emp3thy/arcade-cabinet/docs/docs/README.md

# Docs

Numbered for reading order. `../CLAUDE.md` is the entry point.

| File | Read it when |
|---|---|
| `01-architecture.md` | You need the shape of the system |
| `02-bom.md` | Ordering, or checking what's already bought |
| `03-wiring-lap-pad.md` | Soldering a pad |
| `04-wiring-pi-console.md` | Wiring the Pi box |
| `05-retropie-config.md` | Anything software-side on the Pi |
| `06-enclosure-reference.md` | Doing CAD |
| `07-testing.md` | Bringing hardware up, or signing off |
| `08-open-issues.md` | **Before building the power chain** |
| `09-decision-log.md` | Before changing anything |
| `../comfort-study/` | Ergonomics research and the three comfort variants (2026-09-12) |
