emp3thy/arcade-cabinet/docs/comfort-study/research-2-fightsticks.md

# Research report 2 — fightstick community and manufacturer lap-comfort knowledge

## 1. Stick table
Dims W x D x H mm (H incl. lever where noted). "Palm" = front edge to first control; NO manufacturer or reviewer publishes this, so every row is n/f (not found).

| Stick | W x D x H | kg | Panel | Underside | Palm | Lap-friendly? | Source |
|---|---|---|---|---|---|---|---|
| Qanba Obsidian 2 | 486x260x116 | 3.35 (Qanba) / 3.65 (manual) | plastic, chamfered front edge | full-bottom anti-slip pad | n/f | Yes: "doesn't feel uncomfortable on your lap"; user "wide enough... does not slide" | https://qanbausa.com/obsidian-2/ , https://www.tomsguide.com/gaming/gaming-peripherals/qanba-q7-obsidian-2-review |
| Qanba Drone 2 | 356x221x116 | 1.25 | plastic | 4 rubber corner feet | n/f | Mixed: light, user "sits comfortably in the lap" | https://qanbausa.com/drone-2/ , https://thearcadestick.com/qanba-drone-2/ |
| Qanba Obsidian (Q3) | 460x260x120 | ~3.0 | plastic + aluminium sides | rubber pads | n/f | Yes; Reddit: lasts longer on lap than HRAP N | https://www.profightstick.com/qanba-obsidian-review/ |
| Hori Fighting Stick Alpha | 410x300x120 | 2.7 (Hori); one review says 3.3 | plastic | 2 silicone-rubber pads | n/f | Yes: "rests on your lap easily"; Reddit: depth "fills the space between gut and knees" | https://www.techradar.com/gaming/hori-fighting-stick-alpha-review |
| Hori RAP N Hayabusa | 436x276x63 (body only) | 3.1 | plastic | friction pads | n/f | Mixed: pads praised; Reddit "too bulky for long term play unless I use a table" | https://thearcadestick.com/hori-real-arcade-pro-v-hayabusa/ |
| Victrix Pro FS | 413x279x57 (body) | 3.4-3.5 | aluminium, 6.28 deg wrist slope | foam lap pad on back panel + 2 rubberised panels | n/f | Most praised: "never felt fatigued", wrists less tired than Daija/Alpha. Cons: front headset socket "annoying for lap play" | https://www.turtlebeach.com/products/victrix-pro-fs-arcade-fight-stick , https://gamespace.com/all-articles/tech/victrix-pro-fs-arcade-stick-review/ |
| Razer Panthera Evo | 381x259x64 | 2.1 | plastic, sloped front drop-off | anti-slip rubber strips | n/f | Yes: "rests comfortably on my lap"; one Reddit user: big box "heats my man parts" | https://www.psu.com/reviews/razer-panthera-evo-arcade-stick-review-ps4/ |
| Razer Kitsune | 296x210x19 | 0.8 | aluminium top | full rubber grip layer | n/f | Yes: "0 issues playing in the lap"; cramped for large hands | https://thearcadestick.com/razer-kitsune/ |
| Hit Box / Ultra | 407x179x27 | 1.7 | acrylic on steel | magnetic plate, no-slip foam | n/f | Mixed: "most comfortable to spread out" vs tall boxes cause wrist pain | https://www.hitboxarcade.com/products/hit-box-pc |
| Snack Box Micro / XL | 254x127x13 / 318x152x13 | 0.36-0.9 / 0.45-1.0 | acrylic, rounded edges | neoprene pad | n/f | Micro needs Footsie extender; XL "don't have to squeeze your legs together" | https://thearcadestick.com/snack-box-micro-xl/ |
| Mad Catz TE2+ | ~394x305x64 (unverified) | 2.3 vs >3.4 (unverified) | metal base | non-slip foam at leg contact points | n/f | Split 40-comment thread: "perfect weight" vs "felt like lead" | https://www.reddit.com/r/fightsticks/comments/141aoge/ |
| Nacon Daija | 380x260x70 | 3.5-3.7 | plastic + rubber wrist pad | full rubberised plate | n/f | Mixed: "some may find the sheer weight uncomfortable"; wrist rest "could be more supportive" | https://www.pushsquare.com/features/hardware-review-nacon-daija-arcade-stick-a-ps5-ps4-and-pc-fighting-game-dream |
| AllFightSticks 15.5" case | 394x254x58 | 2.5 | steel/aluminium | n/f | n/f | "may challenge your legs' endurance during lap play" | https://thearcadestick.com/allfightsticks/ |

## 2. Community findings
1. Lap is the default position. Poll: 235 lap vs 46 desk. https://www.reddit.com/r/fightsticks/comments/1679poa/ Consensus.
2. Sliding is the top complaint and friction, not weight, is the fix. SRK 2007: "I put foam rubber on the bottom so they don't slip"; Reddit: non-slip tape "can make a real significant difference"; every current stick ships a near-full-bottom pad. https://archive.supercombo.gg/t/what-do-you-use-to-play-your-arcade-stick-on/24045 Consensus.
3. Weight is polarising; ~2-2.5 kg is the tolerated middle. "Usually the heavier the better but I guess there's a limit"; one user ranks session length HRAP4 (light) > Obsidian > HRAP N (bulky). Common.
4. Case height drives wrist pain more than weight. "Full size arcade button boxes are way too 'tall' to sit on my lap and not develop pain"; thin leverless (<38 mm) users report straight wrists; a thread hunts sub-1.5 in enclosures. https://www.reddit.com/r/fightsticks/comments/1fz6w3f/ Common (leverless).
5. Lap slope (knees below hips) tips the stick away; fixes: footrest, towel/blanket to level, sit forward with feet planted. 6 of 6 respondents agree. https://steamcommunity.com/app/310950/discussions/0/1795152172917478329 Common.
6. Front-edge geometry matters over hours: sloped/chamfered fronts (Victrix 6.28 deg, Panthera drop-off, Obsidian 2 chamfer) praised; sharp "angular drop offs... dig in after a while". Common (reviewers).
7. Width should match relaxed thigh spread. Builder measures leg spread seated before picking length; wide cases let you play "without having to squeeze your legs together". https://www.reddit.com/r/fightsticks/comments/161y6vu/ Common.
8. Depth should fill gut-to-knee so it cannot rock. Hori Alpha's 300 mm depth "won't be moving around"; a builder's 380x280x70 case was "horrible", replaced by 380x230x50. https://archive.supercombo.gg/t/arcade-stick-dimensions/164024 Minority.
9. Builder go-to size: 400x200 mm, 50-70 mm tall (5 builds). Single post.
10. Heat and sweat: legs and pad "get soaked" in long sessions; old metal bottoms rust at thigh contact; metal cases are cold in winter. Minority.
11. Palm resting is contested; agreed points: rest palms not wrists, keep wrist straight. A rest higher than the buttons is claimed better than lower. Contested.
12. Lap desk or lap pad plus wrist rest is the most-recommended add-on for small boxes. Common.

## 3. What builders do about it
- Non-slip: adhesive foam pads sold in pairs, 76 x 152-203 mm; 1.6 mm self-adhesive sheet; 3M anti-slip tape 140x140 mm, two pieces at each end; natural rubber mat 366x239 mm (Mayflash); yoga mat glued under, leather-covered; rug gripper cut to shape.
- Weight: steel plate 0.5-0.9 kg, fishing weights + hot glue, spare metal base plates. Shipped range: lever sticks 2.1-3.6 kg, leverless 0.8-1.7 kg.
- Wedge/slope: 6.28 deg (Victrix), ~6 deg front drop (Panthera), 11 deg wrist slant (Mixbox), lap table tilting to 30 deg.
- Height: leverless target <38 mm total; lever cases 50-70 mm body.
- Footprint: 380-410 x 230-260 mm lever; 400 x 200 leverless.
- Edges: chamfer or slope the front; round all edges (Snack Box).
- Palm space: Footsie extender, Haute42 extender shells, lap desk with cushion.
- Straps: none exist for lap; only shoulder straps for transport.
- Thigh cut-outs: none found in any product or build.

## 4. Gaps
- Palm-rest depth is unpublished everywhere.
- No controlled weight-vs-fatigue data; all anecdotal.
- Conflicting weights: TE2+, Snack Box Micro, Hori Alpha.
- forums.shoryuken.com unusable; only the supercombo archive.
- r/fightsticks sampled 12 threads, not exhaustively.
