emp3thy/arcade-cabinet/docs/comfort-study/research-3-lapboards.md

# Research report 3 — lap desks, lapboards, anthropometrics

## 1. Devices (W x D x H mm, weight, underside, tilt, sofa/lap verdict)

| Device | W x D x H mm | kg | Underside | Tilt | Sofa/lap verdict | Source |
|---|---|---|---|---|---|---|
| LapGear Designer | 439 x 338 x 71 | 0.91 | single microbead bean bag | 0 | Praised: "conforms to your lap for a strong and stable work platform" | https://www.techgearlab.com/topics/home/best-lap-desk , https://lapdesk.com/products/designer-lap-desk |
| Honey-Can-Do TBL-06320 | 593 x 400 x 64 | 1.44 | flat foam cushion | 0 | No stability reviews found | https://www.amazon.com/Honey-Can-Do-TBL-06320-Portable-Laptop-Handle/dp/B013TSVMJM |
| Huanuo dual-cushion (16 in model) | 550 x 370 x ~64 | 2.04 | two foam bolsters (two-rail) | not stated | Criticised: mouse pad puts laptop left so "weight rests more on your left leg"; devices "tilt forward" on lap | https://appleinsider.com/articles/23/06/03/huanuo-lap-desk-review-comfort-and-convenience-for-macbook-users |
| North Coast Posture-Rite | 394 x 337 tray, base 57 to 95 | 0.57 | styrofoam-bead bag, wedge | 0 to 20 deg | Vendor claims stable in bed/couch/wheelchair; unverified | https://www.rehabmart.com/product/posture-rite-lap-desk-6371.html |
| Logitech K400 Plus | 354 x 139 x 24 | 0.39 | flat rigid, feet | ~0 (unverified) | Praised: "less mass on your thighs" | https://www.gomechanicalkeyboard.com/comparisons/logitech-k400-vs-k400-plus-review/ |
| Corsair K63 Lapboard | 671 x 277 x 53 | 1.85 | flat memory foam, full width, 13 mm (PCPer) or ~25 mm (Inverse) | 0 | Praised comfortable; criticised heavy/hot, no centring bump, mouse slides because lap "rarely completely level" | https://pcper.com/2018/05/corsair-k63-wireless-mechanical-gaming-keyboard-and-lapboard-combo-review/ , https://www.pcworld.com/article/402216/corsair-k63-gaming-lapboard-review.html |
| Corsair Lapdog | 735 x 261 x 94 | 2.63 | memory foam with slight central bump | 0 | Criticised: "sit with legs apart in order to prevent any seesaw motion"; front drop-off "feels sharp on your palm" | https://m.hexus.net/tech/reviews/peripherals/92927-corsair-lapdog/?page=2 , https://www.kitguru.net/peripherals/leo-waldock/corsair-lapdog-review/ |
| Roccat Sova | 646 x 280 x 37 | 2.35 to 2.6 | four thick foam pads at corners | 0 | Praised: "the weight and how it's distributed"; can be shifted so keyboard sits square on lap; hard mouse surface slides due to leg incline | https://www.makeuseof.com/tag/roccat-sova-review/ , https://bit-tech.net/reviews/tech/peripherals/roccat-sova-mk-review/1/ |
| Razer Turret (Xbox) | dims unverified | 1.86 with tray | flat rigid, high-friction rubber pad | 0, angled wrist rest | Praised stays put; "play angle is lower than on a desk", fatigue in long sessions | https://www.techradar.com/reviews/razer-turret-for-xbox-one , https://www.thexboxhub.com/razer-turret-for-xbox-one-review/ |
| Couchmaster Cycon 2 | board 820 x 330 x 30; cushions 600 x 165 x 200 each | 1.7 + 2 x 0.66 | board bridges two cushions beside hips, not on thighs | 0 | Praised stable; criticised no lip, mouse slides if wrist overbalances | https://www.gadgetexplained.com/2021/08/nerdytec-couchmaster-cycon-2-review-lap.html , https://gamingtrend.com/reviews/couchmaster-cycon-2-review-comfy-couch-gaming-gear/ |

## 2. Anthropometrics

Computed from the ANSUR II working database CSV (US Army 2012, male n=4082, female n=1986, mm; https://calmcode.io/static/data/ergonomics.csv, origin https://phc.amedd.army.mil/topics/workplacehealth/ergo/Pages/Anthropometric-Database.aspx). 5th / 50th / 95th:

| Dimension | Male | Female |
|---|---|---|
| Hip breadth sitting | 333 / 378 / 431 | 348 / 397 / 456 |
| Thigh clearance (seat to top of thigh) | 157 / 180 / 207 | 145 / 167 / 191 |
| Thigh circumference, upper | 532 / 624 / 723 | 527 / 613 / 711 |
| Lower thigh circumference (above knee) | 359 / 408 / 463 | 347 / 398 / 465 |
| Popliteal height | 390 / 430 / 471 | 350 / 387 / 428 |
| Buttock-popliteal length | 459 / 502 / 548 | 441 / 483 / 535 |

Cross-checks: FAA HFDS ch.14 (1988 Army data) thigh clearance M 149/168/190, F 140/158/180. Pheasant British adults thigh thickness M 130/155/180, F 120/150/180. Army sample is leaner than civilians; treat 95th values as low.

Derived (estimates, unverified): upper-thigh width per leg is about half of seated hip breadth, 167 to 228 mm across genders and percentiles; circumference/pi gives 168 to 230 mm, consistent. Width just above the knee is about 110 to 150 mm. Thigh gap at the crotch is ~0. No published data on the inter-thigh gap in relaxed sitting was found; 0 to 100 mm at mid-thigh is a plausible range. Thigh crest spacing (the two contact lines) is therefore ~170 to 230 mm with knees together, growing to ~250 to 350 mm with a 100 mm knee gap. A 280 mm wide device sits with both edges on or outside the crests only while crest spacing is under ~250 mm; beyond that its edges ride the inner slopes and it can rock.

## 3. Findings

1. Conforming bean/microbead bases get the best stability comments on soft seating because they fill the valley between the thighs and the sofa cushion curve (TechGearLab, Wirecutter on LapGear Designer). Confidence: medium, reviewer consensus, no measurements.
2. Flat rigid foam works only when the board is wide enough and heavy enough to load both thighs (K63 full-width memory foam "helps it to set level"). Without a centring feature it drifts: PCWorld missed the Lapdog's "slight bump ... which helped keep it centered between my legs". Medium.
3. Two-rail bolster bases are the most criticised: Huanuo dual cushion loads one leg, Mind Reader "not as stable ... narrow bolstered padding design" (TechGearLab). Rails that do not match the user's thigh spacing produce rocking. Medium.
4. Mass helps friction but hurts if off-centre: Lapdog 2.63 kg still seesaws; Sova praised because mass is centred and the user can slide the keyboard square over the thighs. Keep centre of mass low and between the thigh crests. Medium-high.
5. Front edge: a steep front drop-off is painful on the palms (Lapdog); a padded, angled front wrist rest is praised (Turret, Sova). The lap desk raises the work surface off the thighs: Asundi et al. measured head tilt down 4 deg, neck flexion down 2 deg, wrist extension down 9 deg versus bare lap (https://www.researchgate.net/publication/41002099). High for the study, medium for edge geometry.
6. Tilt: thighs slope down to the knee on a sofa, so items slide forward (Sova, K63, Huanuo). Bean-bag desks offer 0 to 20 deg (Posture-Rite); lapboards are 0 deg and rely on lips or friction. A few degrees of rearward tilt or a front lip compensates. Medium.
7. Bypassing the thighs: Couchmaster bridges 200 mm cushions beside the hips; older patents (US2763522, US2596094) use struts to the chair seat retained by the thighs. Both avoid thigh-slope instability entirely. Medium.
8. Heat: full-contact foam or bead bases trap heat (TechGearLab, K63 users); patent US12402720 (2025, single foam block lap desk) adds front-to-rear cooling channels and a U-shaped "hugging" recess. Low.

## 4. Gaps

- No measured tilt or rocking tests exist; all stability verdicts are subjective.
- No beanbag-chair-specific reviews found.
- No anthropometric data on knee or thigh gap in relaxed sitting.
- DINED (Dutch) needs a login; not used.
- Razer Turret Xbox dimensions unverified; K63 foam thickness conflicts between sources.
- Corsair official weight page has no spec; 1.85 kg is from reviews.
