emp3thy/arcade-cabinet/cad/art/chunli.png

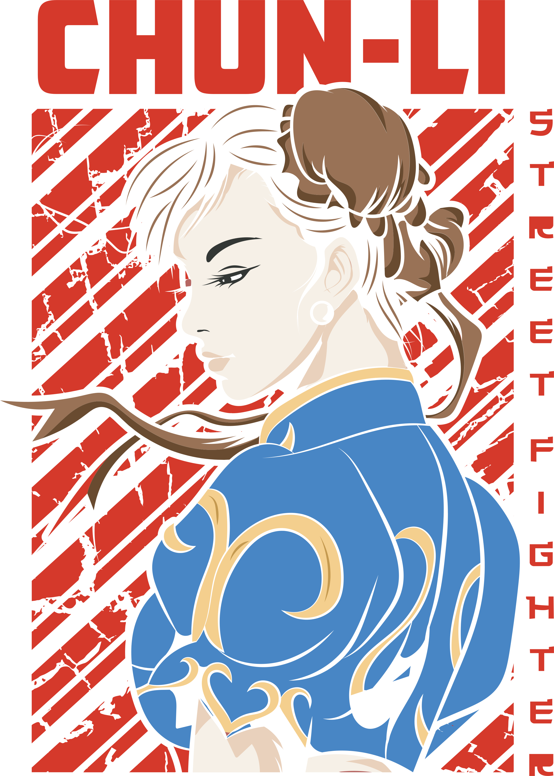
cad/art/chunli.png
