emp3thy/arcade-cabinet/cad/art/drum/chunli_sil.png

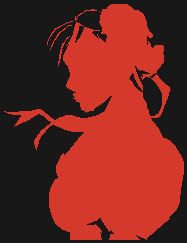
cad/art/drum/chunli_sil.png
