emp3thy/arcade-cabinet/cad/art/layers/all/_preview.png

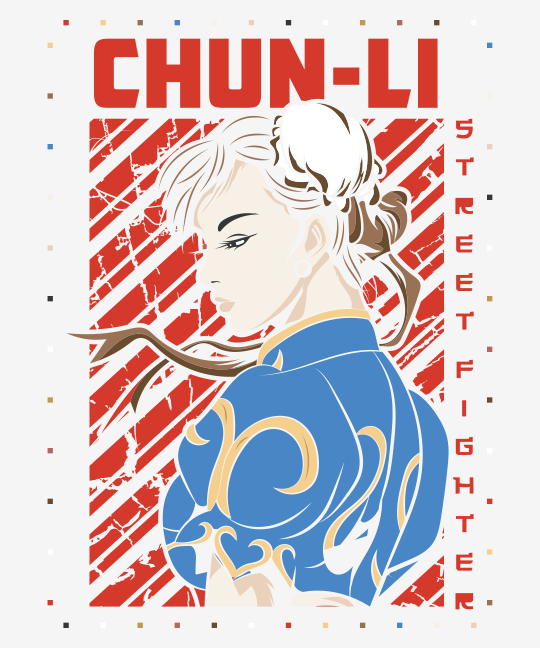
cad/art/layers/all/_preview.png
