emp3thy/arcade-cabinet/cad/art/layers/set5/_bun_white_brown.png

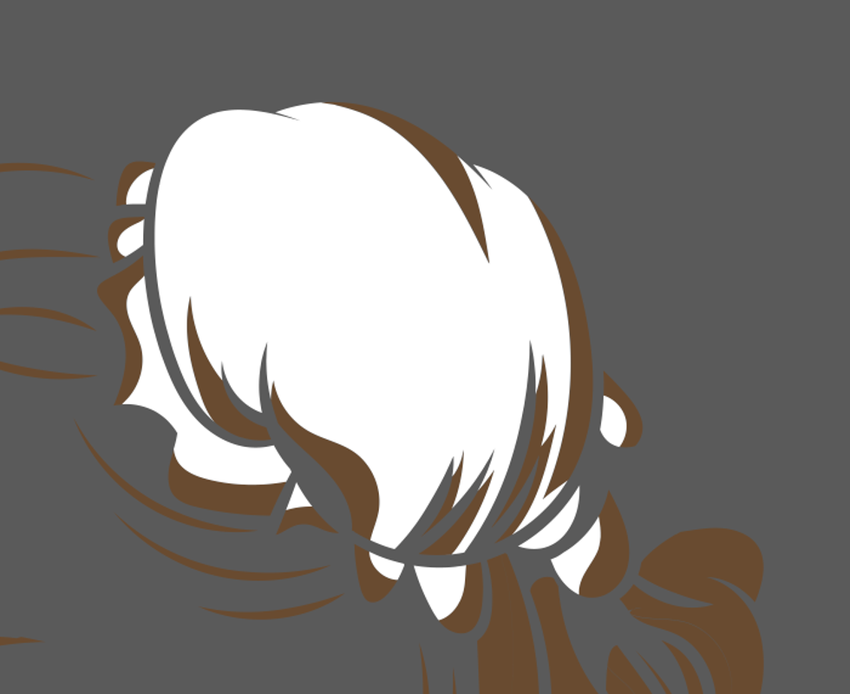
cad/art/layers/set5/_bun_white_brown.png
