emp3thy/arcade-cabinet/cad/renders/lap_disc_art_iso.png

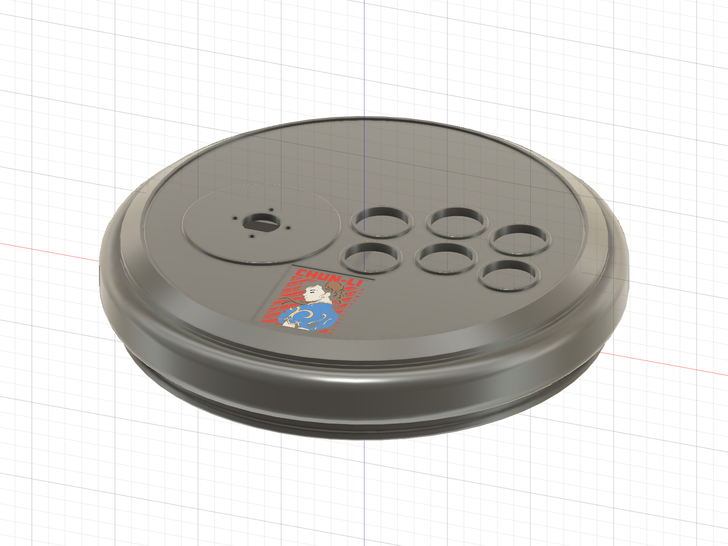
cad/renders/lap_disc_art_iso.png
