emp3thy/arcade-cabinet/cad/renders/lap_disc_art_pocket.png

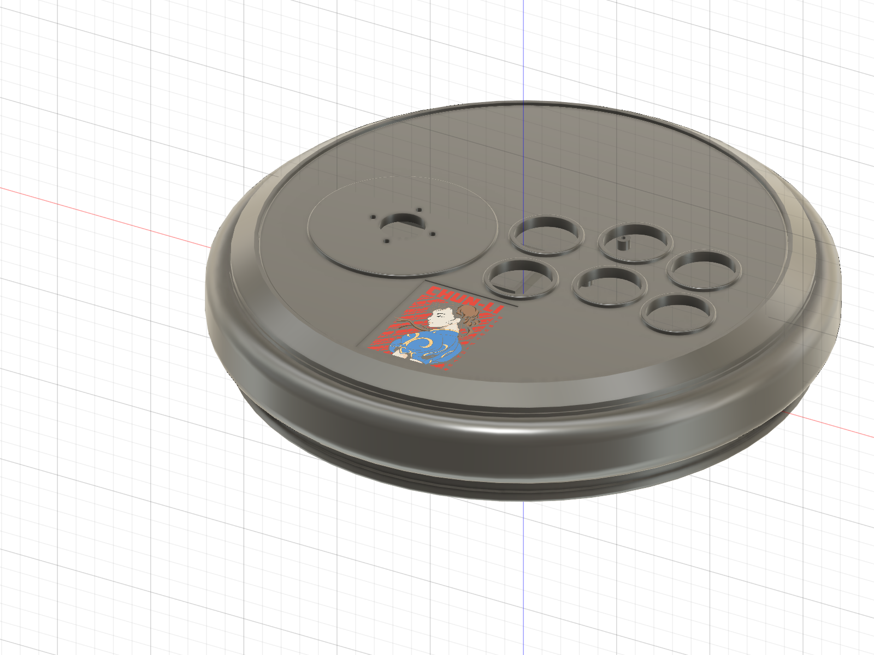
cad/renders/lap_disc_art_pocket.png
