emp3thy/arcade-cabinet/cad/renders/lap_disc_art_top.png

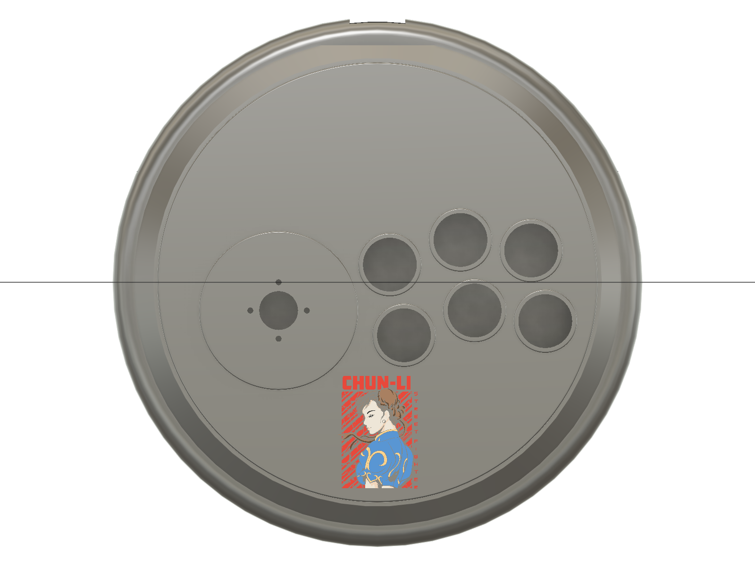
cad/renders/lap_disc_art_top.png
