emp3thy/arcade-cabinet/cad/renders/lap_disc_stageA_iso.png

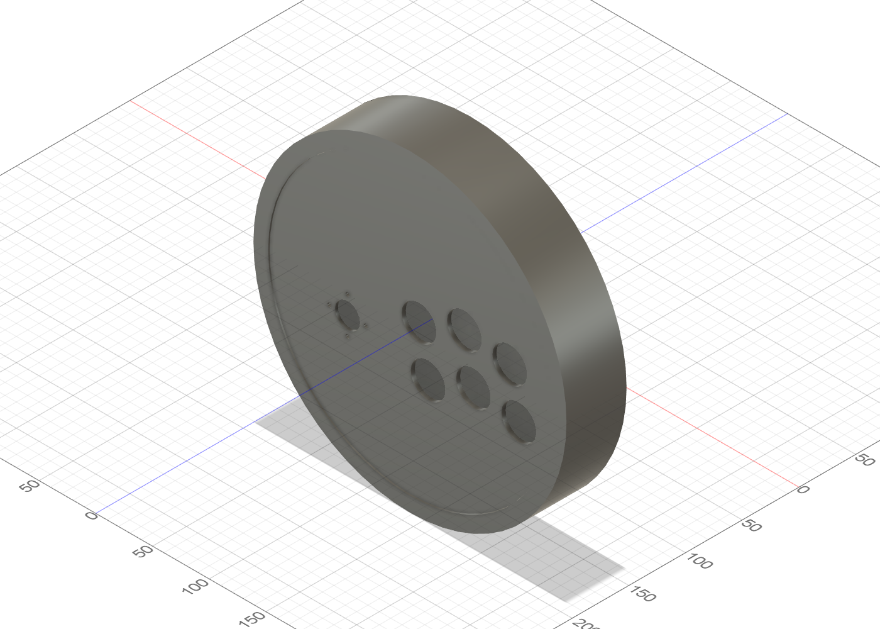
cad/renders/lap_disc_stageA_iso.png
