emp3thy/arcade-cabinet/cad/renders/lap_disc_stageB_iso.png

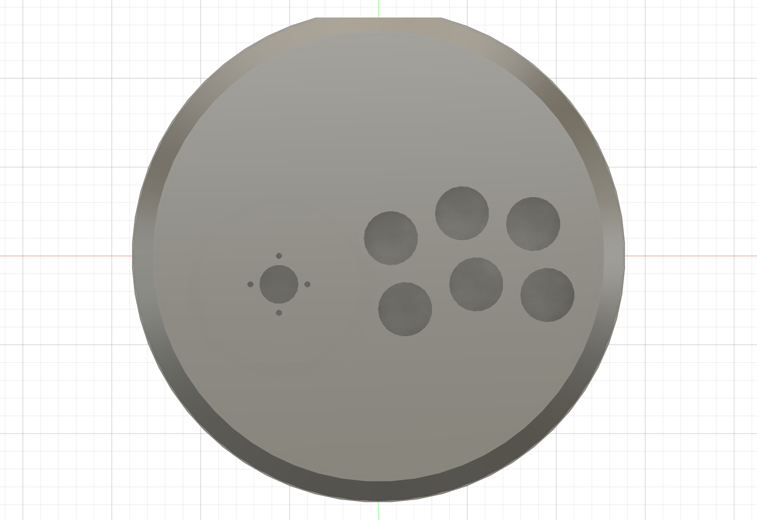
cad/renders/lap_disc_stageB_iso.png
