emp3thy/arcade-cabinet/cad/renders/lap_disc_stageC_iso.png

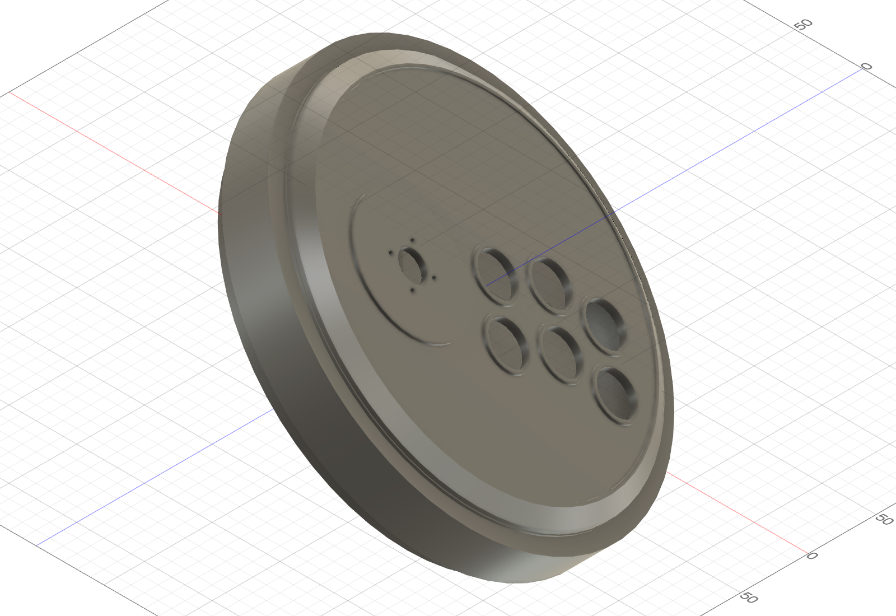
cad/renders/lap_disc_stageC_iso.png
