emp3thy/arcade-cabinet/cad/renders/lap_disc_stageC_underside.png

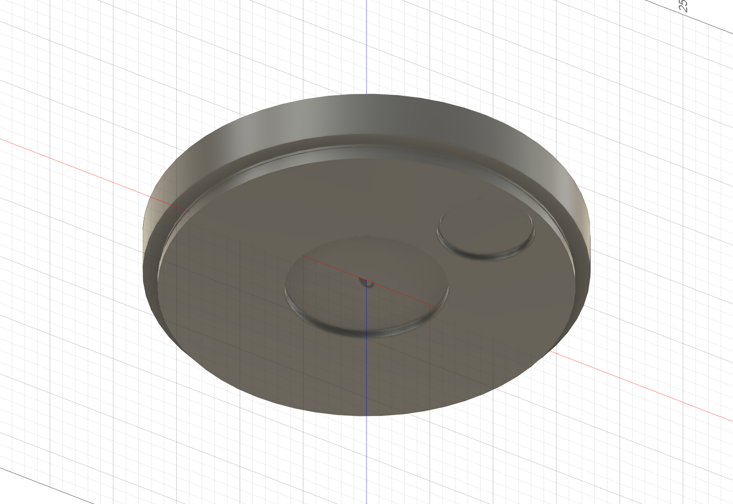
cad/renders/lap_disc_stageC_underside.png
