emp3thy/arcade-cabinet/cad/renders/lap_disc_stageD_edge.png

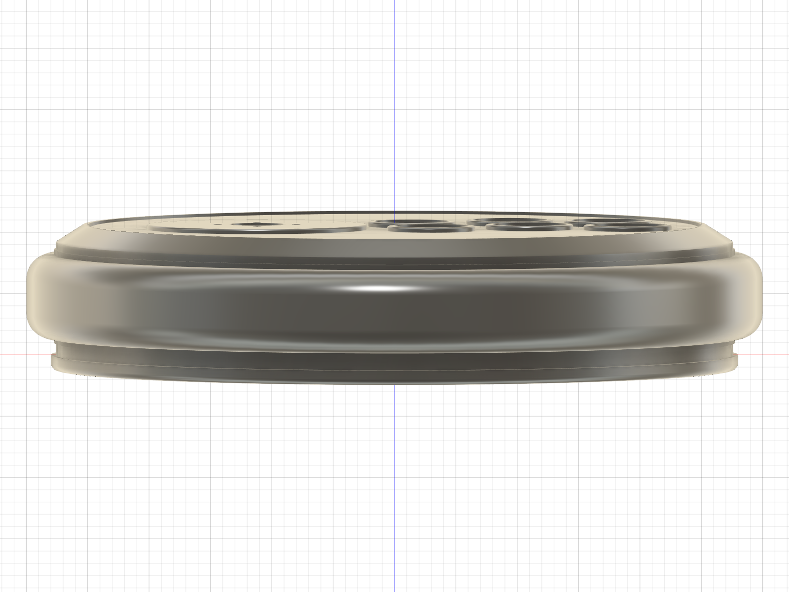
cad/renders/lap_disc_stageD_edge.png
