emp3thy/arcade-cabinet/cad/renders/lap_disc_stageD_iso.png

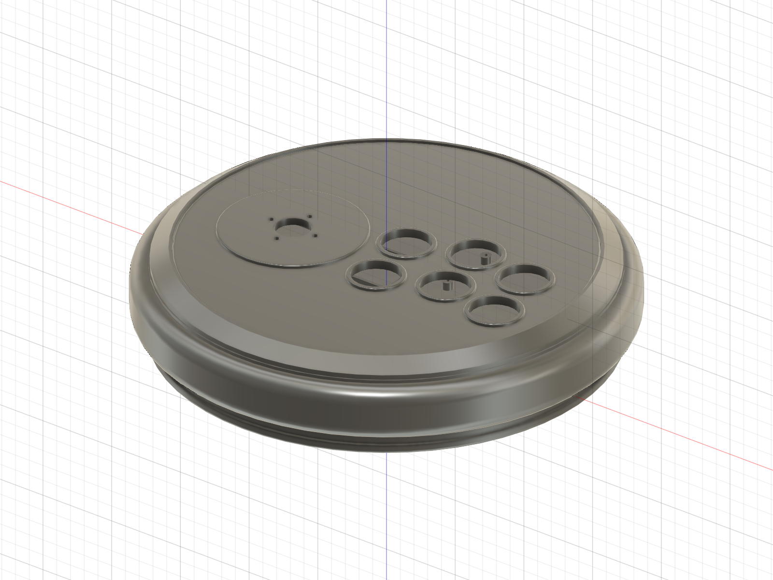
cad/renders/lap_disc_stageD_iso.png
