emp3thy/arcade-cabinet/cad/renders/lap_disc_stageD_underside.png

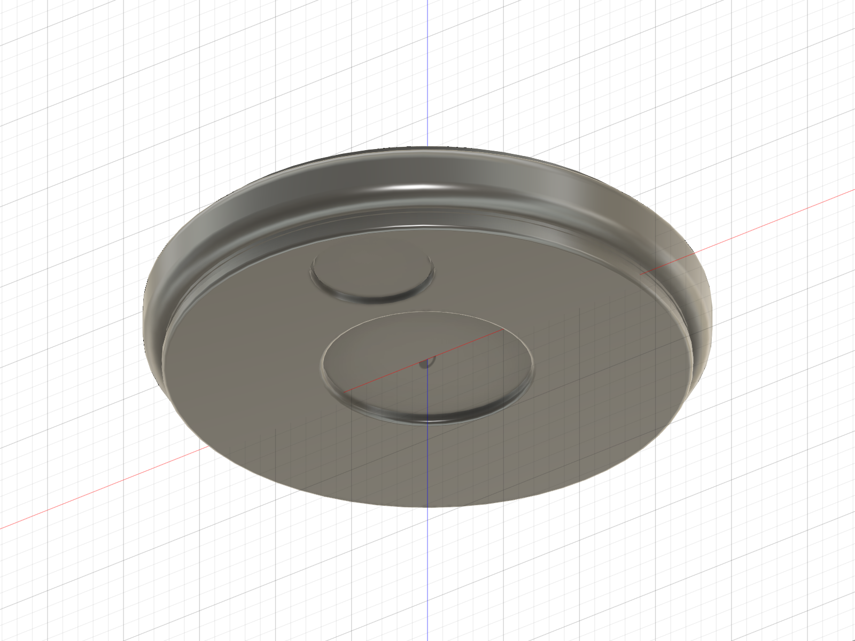
cad/renders/lap_disc_stageD_underside.png
