emp3thy/arcade-cabinet/cad/renders/lap_disc_stageE_rear_iso.png

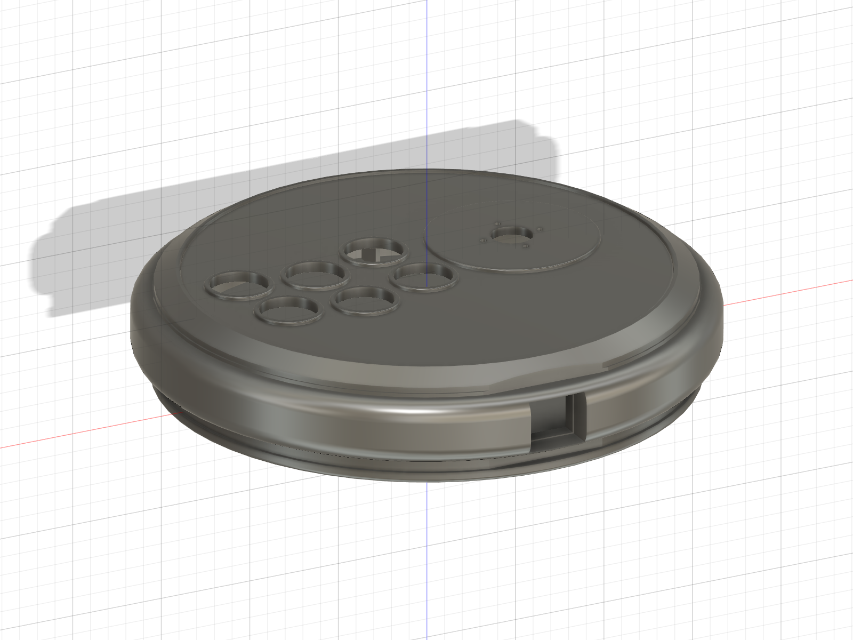
cad/renders/lap_disc_stageE_rear_iso.png
