emp3thy/arcade-cabinet/cad/renders/lap_disc_stageH_hoops.png

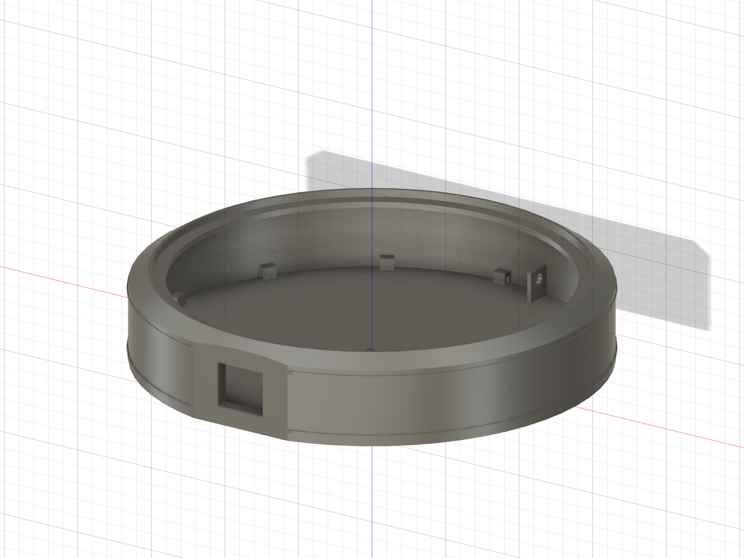
cad/renders/lap_disc_stageH_hoops.png
