emp3thy/arcade-cabinet/cad/renders/lap_disc_stageH_internals.png

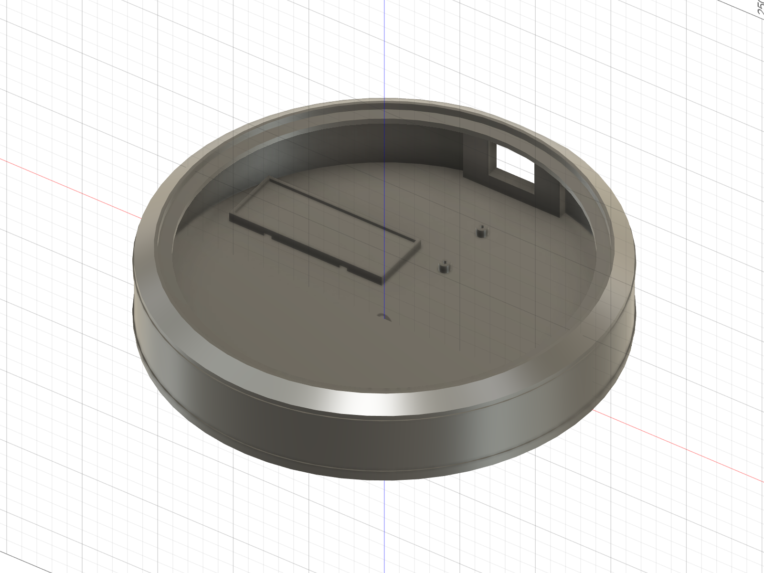
cad/renders/lap_disc_stageH_internals.png
