emp3thy/arcade-cabinet/cad/renders/lap_disc_stageH_lipo.png

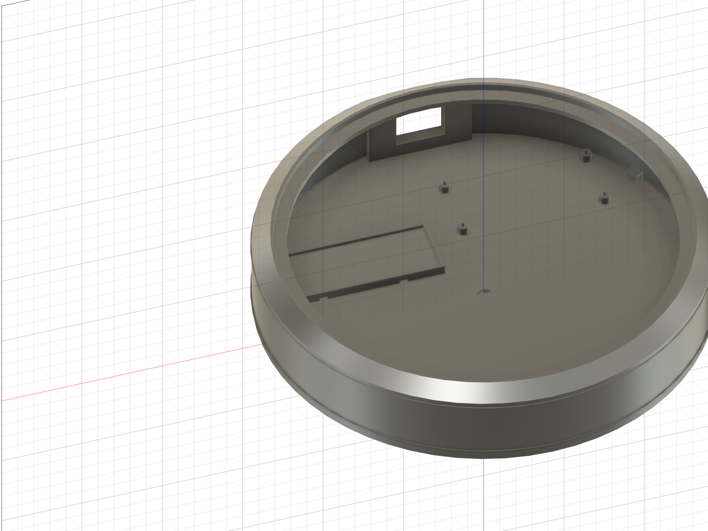
cad/renders/lap_disc_stageH_lipo.png
