emp3thy/arcade-cabinet/cad/renders/lap_disc_stageI_port_inside.png

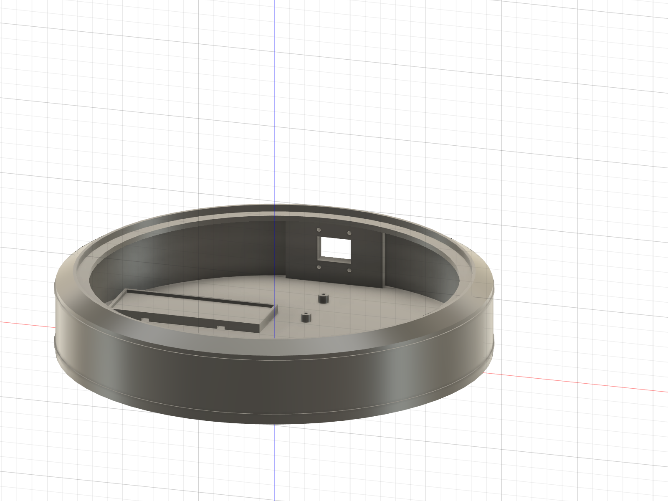
cad/renders/lap_disc_stageI_port_inside.png
