emp3thy/arcade-cabinet/cad/renders/lap_disc_stageI_port_outside.png

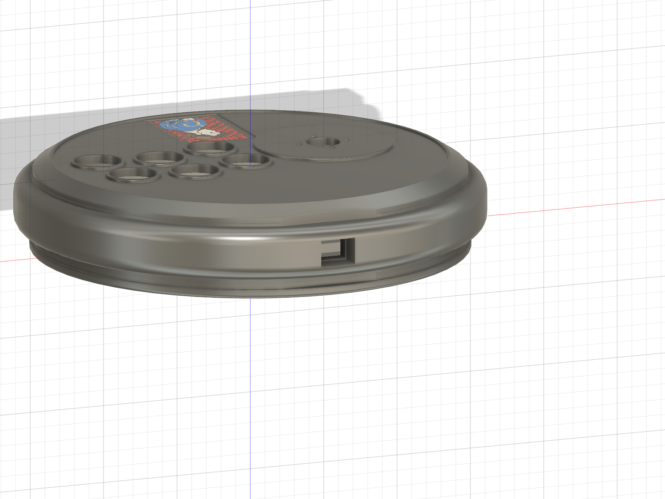
cad/renders/lap_disc_stageI_port_outside.png
