emp3thy/arcade-cabinet/cad/renders/lap_disc_stageJ_plate_under.png

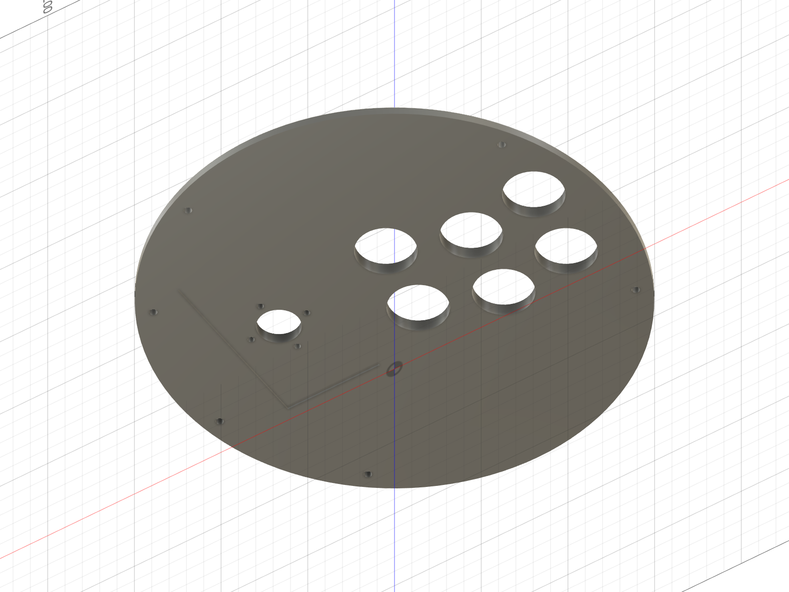
cad/renders/lap_disc_stageJ_plate_under.png
