emp3thy/arcade-cabinet/cad/renders/lap_disc_stageJ_ring_inside.png

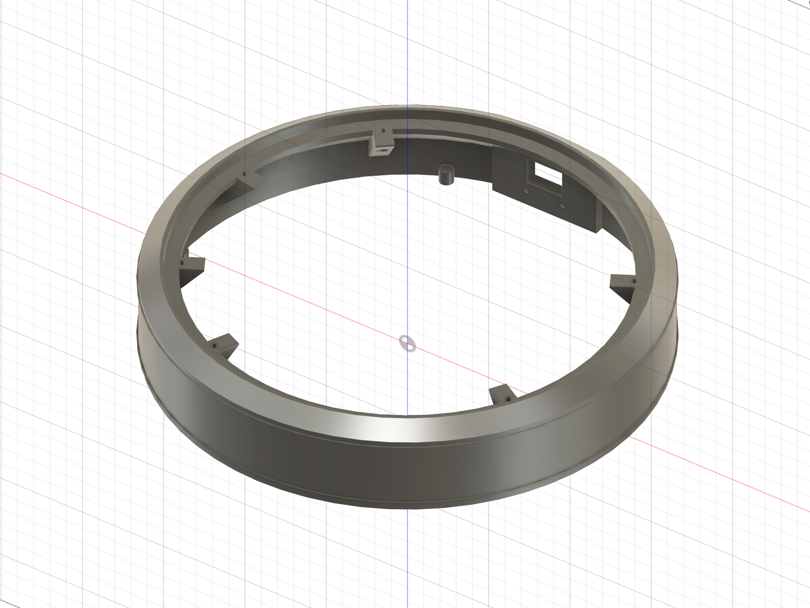
cad/renders/lap_disc_stageJ_ring_inside.png
