emp3thy/arcade-cabinet/cad/renders/lap_disc_stageJ_sled.png

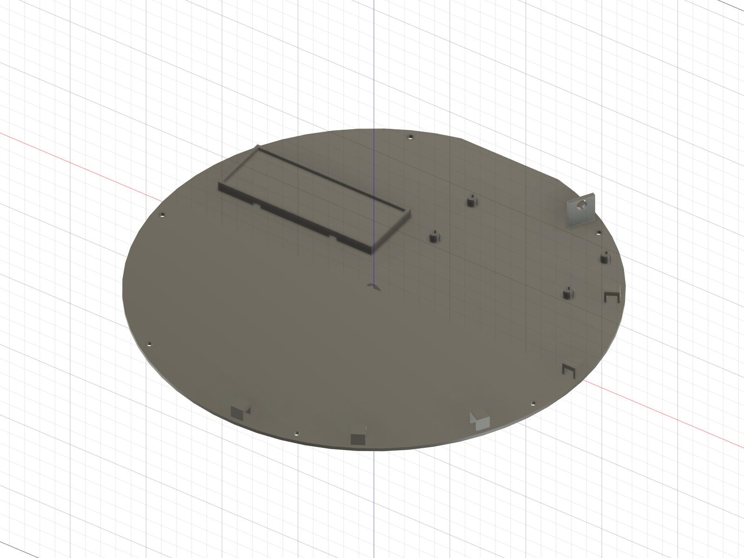
cad/renders/lap_disc_stageJ_sled.png
