emp3thy/arcade-cabinet/cad/renders/lap_disc_stageJ_tpu_below.png

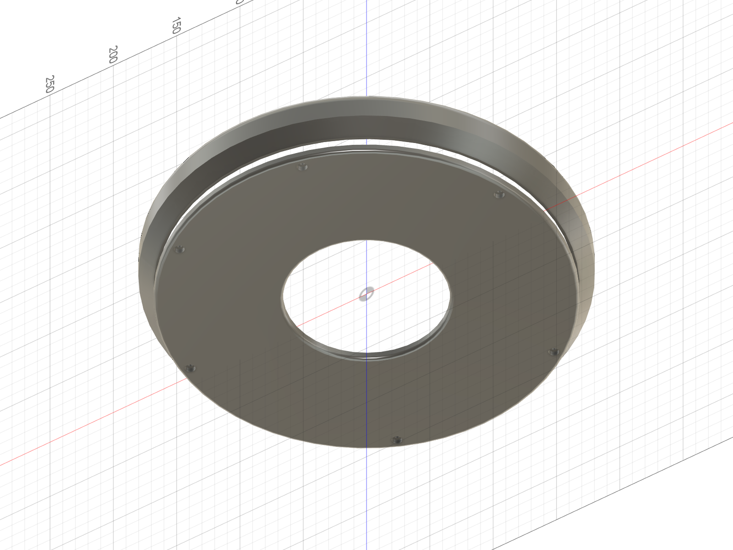
cad/renders/lap_disc_stageJ_tpu_below.png
