emp3thy/arcade-cabinet/cad/renders/lap_disc_stageK_ridges.png

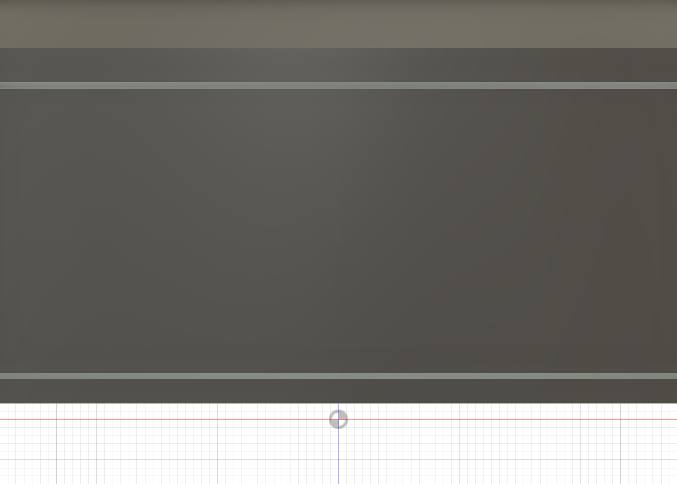
cad/renders/lap_disc_stageK_ridges.png
