emp3thy/arcade-cabinet/cad/renders/lap_disc_stageK_ring_below.png

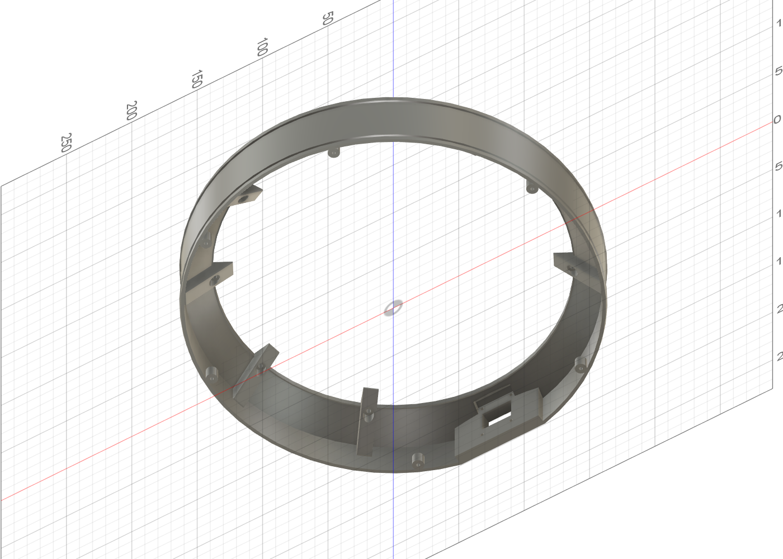
cad/renders/lap_disc_stageK_ring_below.png
