emp3thy/arcade-cabinet/cad/renders/lap_disc_stageK_sled_bolts.png

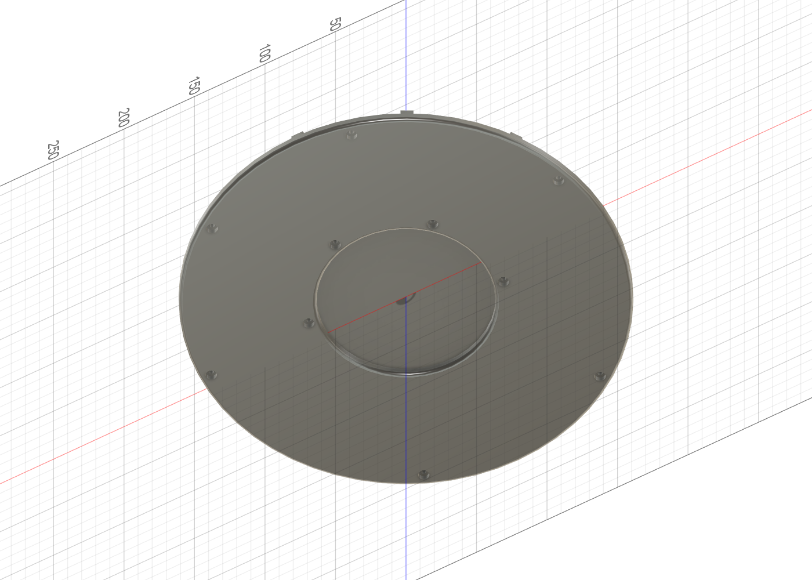
cad/renders/lap_disc_stageK_sled_bolts.png
