emp3thy/arcade-cabinet/cad/renders/lap_disc_stageL_boss_face2.png

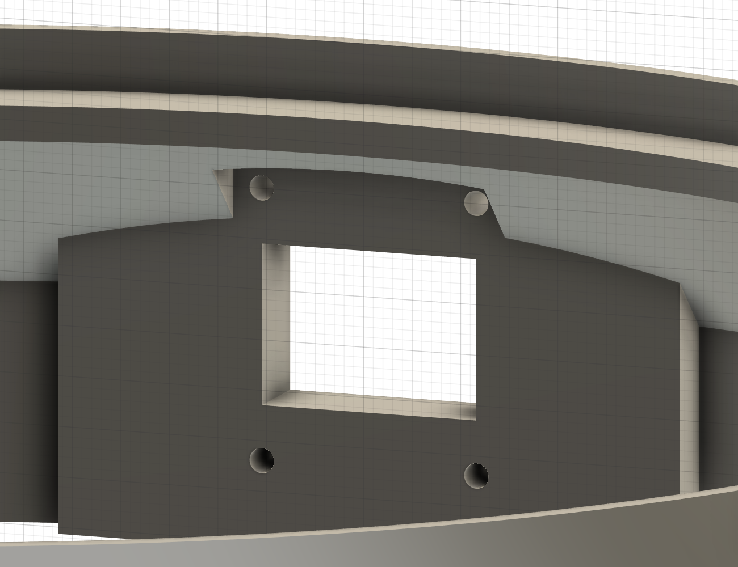
cad/renders/lap_disc_stageL_boss_face2.png
