emp3thy/arcade-cabinet/cad/renders/lap_disc_stageL_port_boss.png

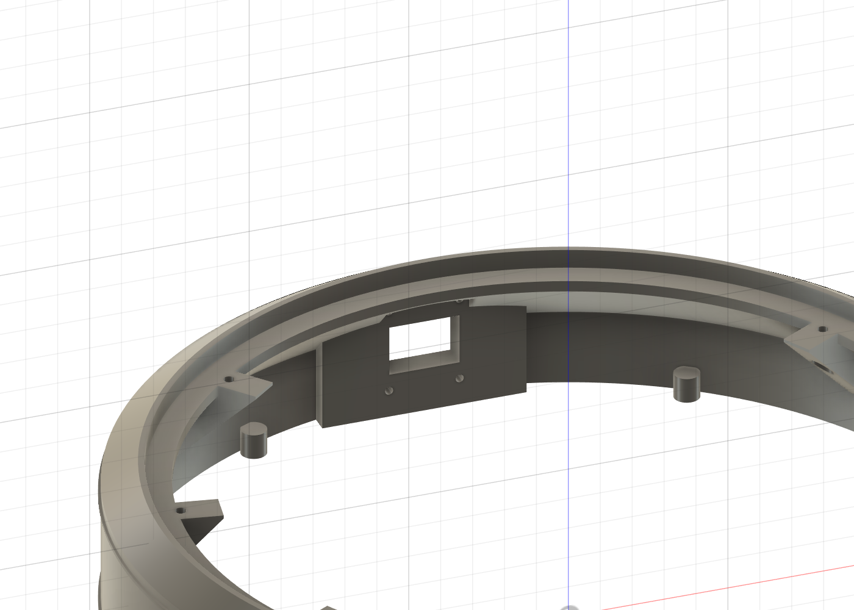
cad/renders/lap_disc_stageL_port_boss.png
