emp3thy/arcade-cabinet/cad/renders/lap_disc_stageL_ring_inside.png

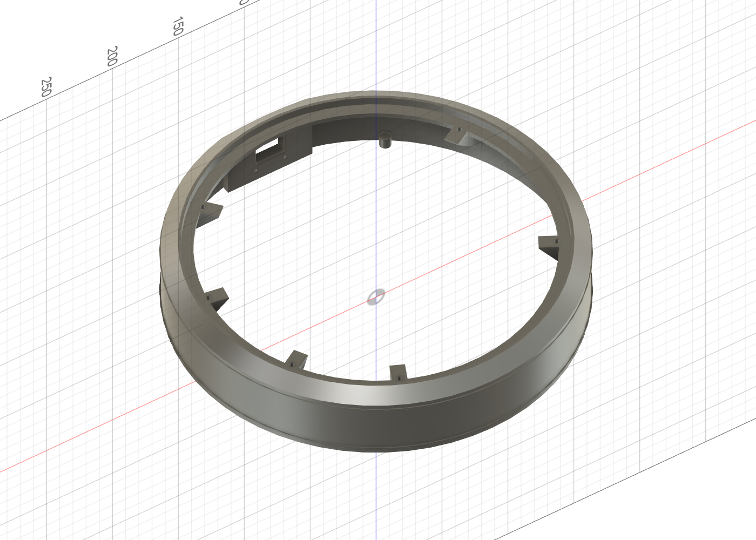
cad/renders/lap_disc_stageL_ring_inside.png
