emp3thy/arcade-cabinet/cad/renders/lap_disc_stageL_ring_port.png

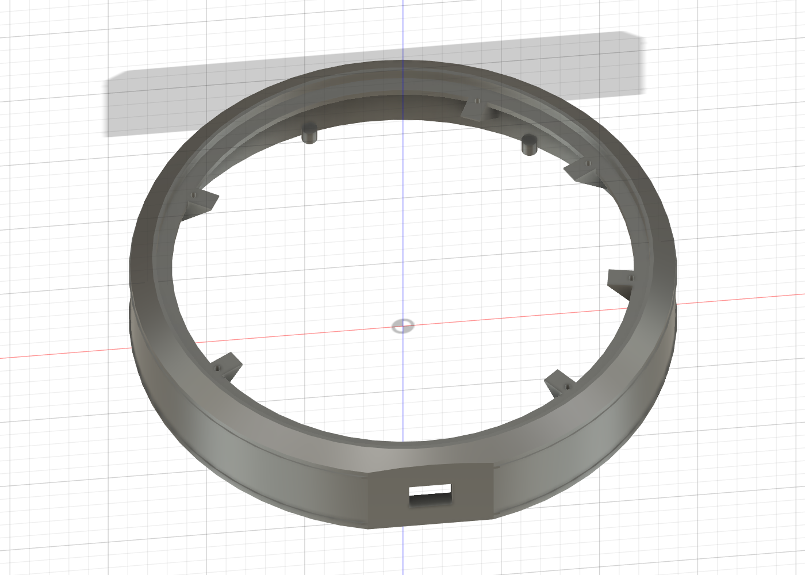
cad/renders/lap_disc_stageL_ring_port.png
