emp3thy/arcade-cabinet/cad/renders/lap_disc_stageO_bracket.png

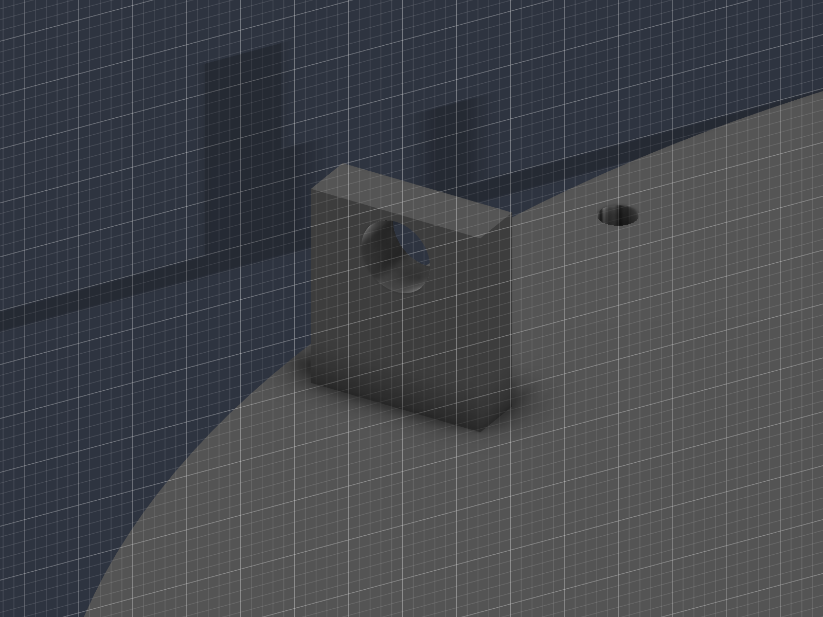
cad/renders/lap_disc_stageO_bracket.png
