emp3thy/arcade-cabinet/cad/renders/lap_disc_stageO_port_outside.png

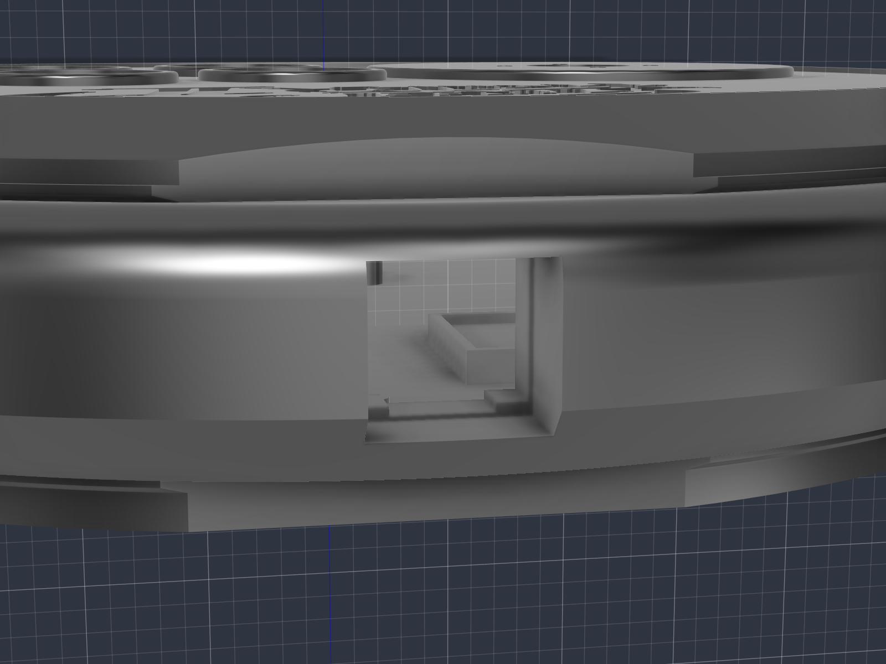
cad/renders/lap_disc_stageO_port_outside.png
