emp3thy/arcade-cabinet/cad/renders/lap_disc_stageO_sled_antenna.png

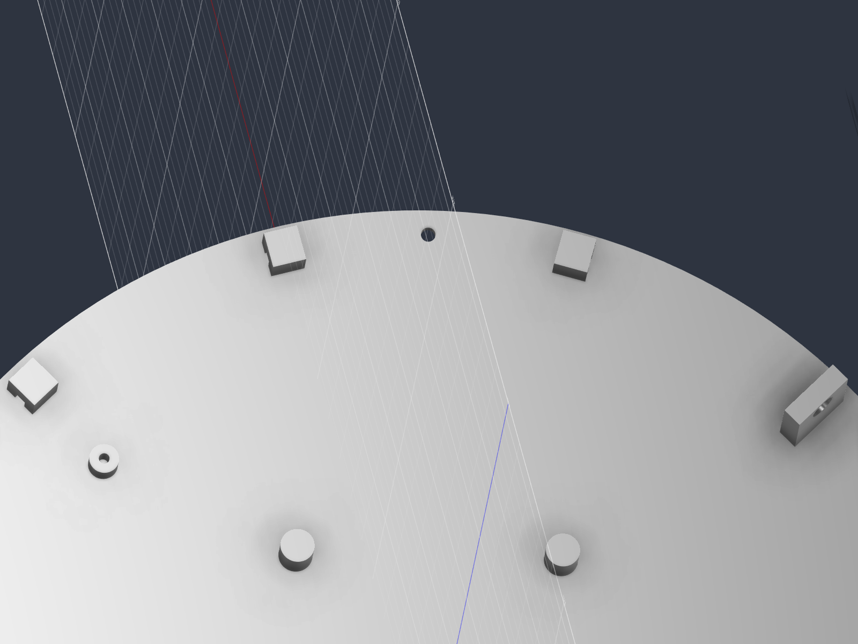
cad/renders/lap_disc_stageO_sled_antenna.png
