emp3thy/arcade-cabinet/cad/renders/pi_drum_stageA_iso.png

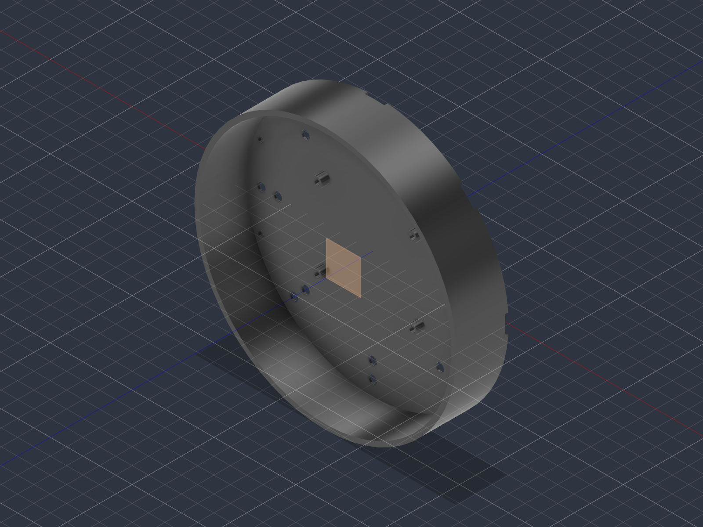
cad/renders/pi_drum_stageA_iso.png
