emp3thy/arcade-cabinet/cad/renders/pi_drum_stageC_iso.png

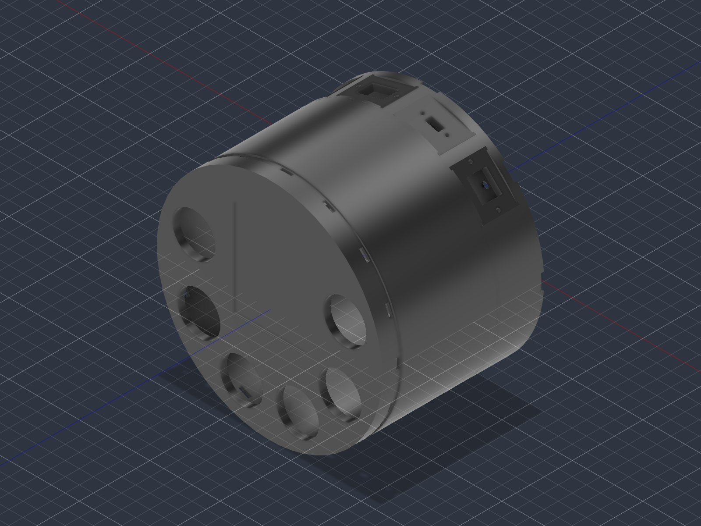
cad/renders/pi_drum_stageC_iso.png
