emp3thy/arcade-cabinet/cad/renders/pi_drum_stageC_top.png

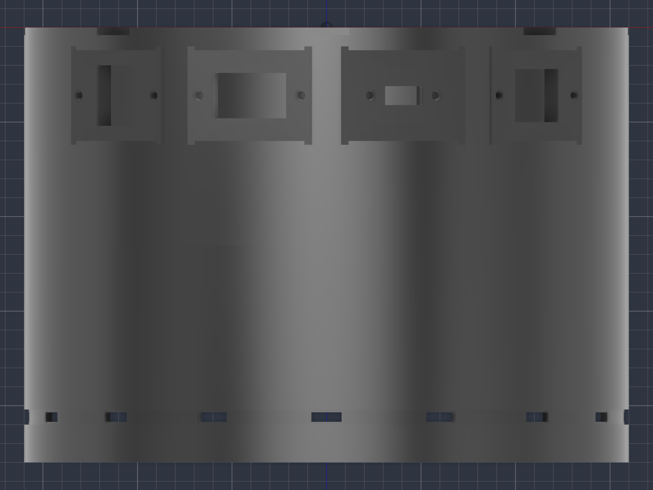
cad/renders/pi_drum_stageC_top.png
