emp3thy/arcade-cabinet/cad/renders/pi_drum_stageD_front.png

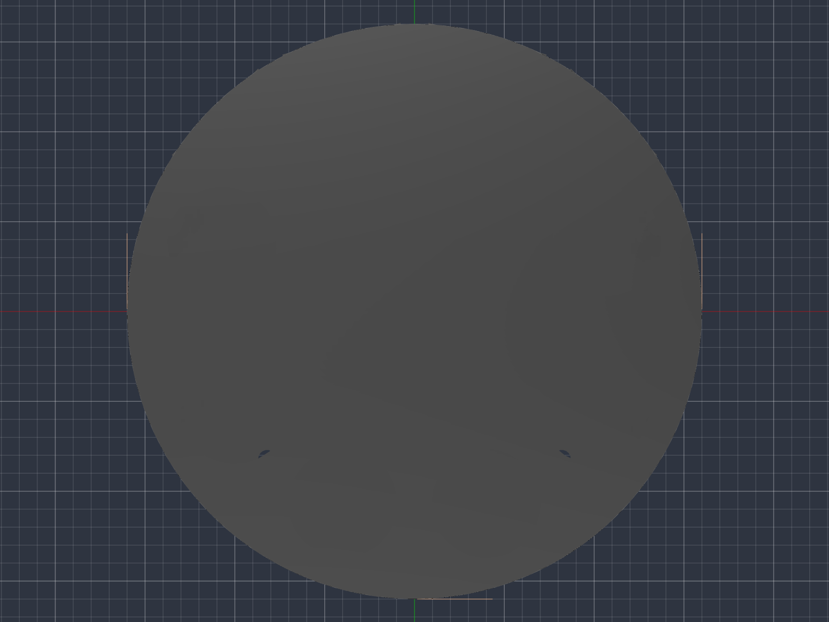
cad/renders/pi_drum_stageD_front.png
