emp3thy/arcade-cabinet/cad/renders/pi_drum_stageD_right.png

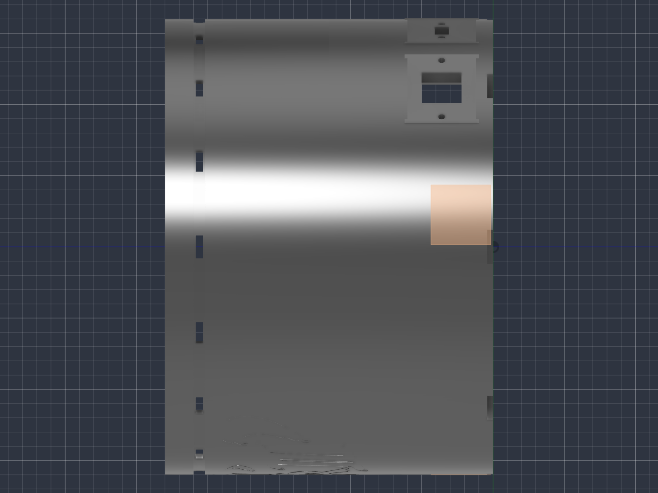
cad/renders/pi_drum_stageD_right.png
