emp3thy/arcade-cabinet/cad/renders/pi_drum_stageE_cup_below.png

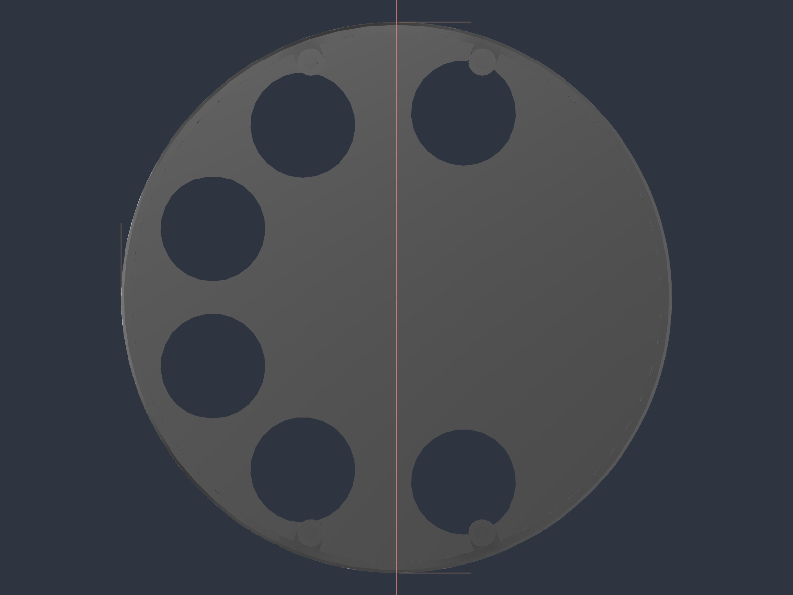
cad/renders/pi_drum_stageE_cup_below.png
