emp3thy/arcade-cabinet/cad/renders/pi_drum_stageE_front.png

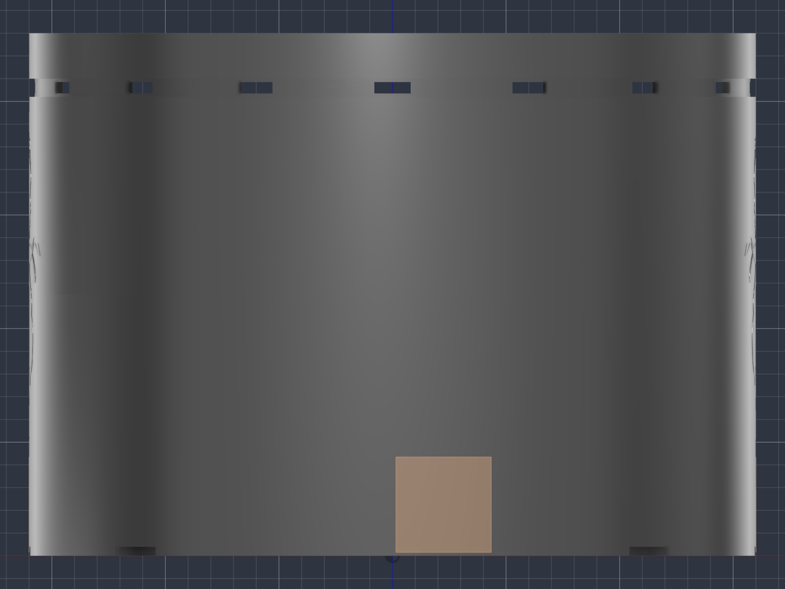
cad/renders/pi_drum_stageE_front.png
