emp3thy/arcade-cabinet/cad/renders/pi_drum_stageE_right.png

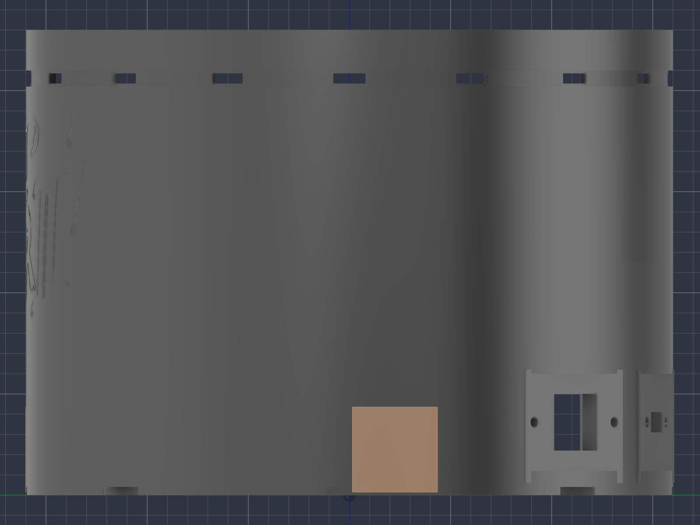
cad/renders/pi_drum_stageE_right.png
