emp3thy/arcade-cabinet/cad/renders/pi_drum_stageE_top.png

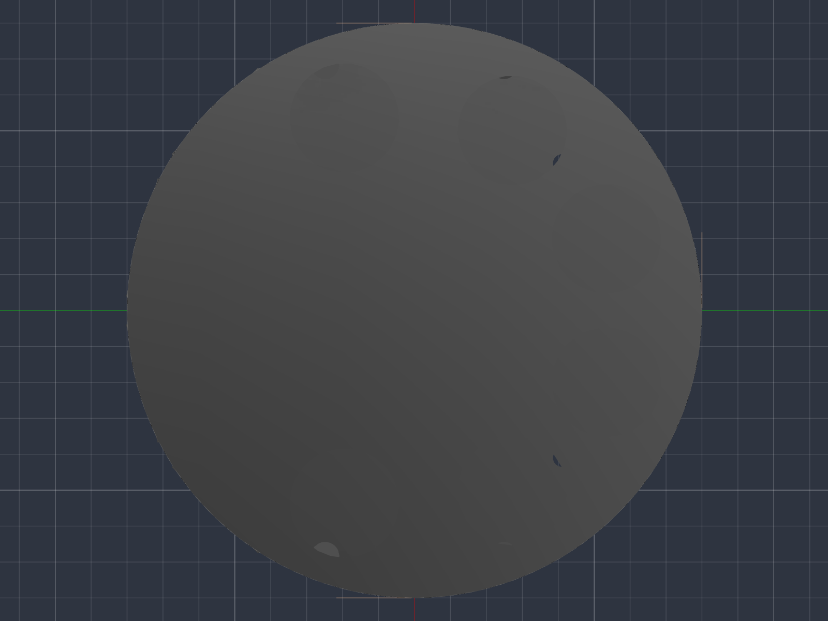
cad/renders/pi_drum_stageE_top.png
