emp3thy/arcade-cabinet/cad/renders/pi_drum_stageF_iso.png

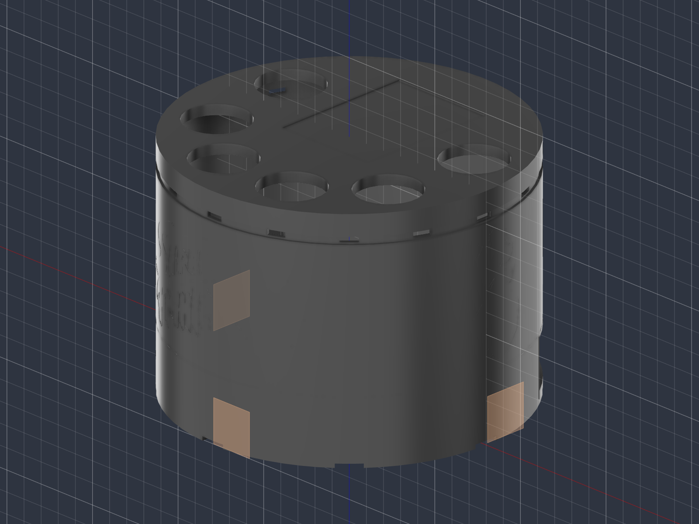
cad/renders/pi_drum_stageF_iso.png
