emp3thy/arcade-cabinet/cad/renders/pi_drum_stageF_left_recess.png

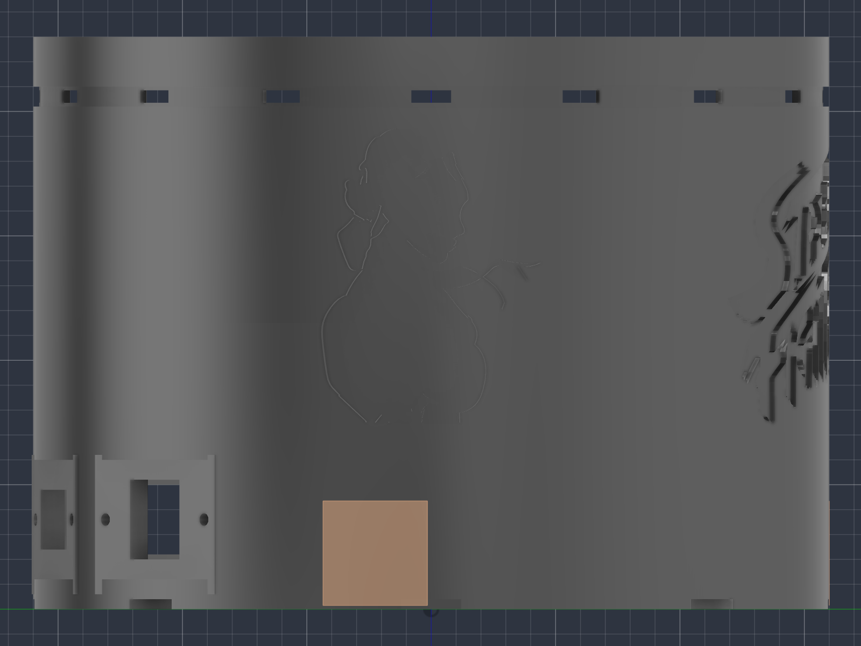
cad/renders/pi_drum_stageF_left_recess.png
