emp3thy/arcade-cabinet/docs/docs/02-bom.md

# 02 — Bill of Materials

Status key: `PURCHASED` · `HAVE` (already owned) · `NEEDED` · `NOT NEEDED`
(deliberately designed out — do not re-add without reading the decision log).

Inventory last confirmed **2026-04-04**; statuses revised **2026-09-06** for
D-010 (TP4056 out) and D-011 (enclosure CAD moves to Fusion). Verify before
ordering.

## Lap pad — per controller

| Role | Part | Status |
|---|---|---|
| Wireless encoder | Brook Gen 5W Wireless Fighting Board | PURCHASED |
| Battery | 3.7 V 3700 mAh LiPo pack, 103395 (95×33×10 mm) | PURCHASED |
| ~~Wireless charge Rx~~ | ~~Qi receiver module, 5 V output, ~50 mm coil~~ | **NOT NEEDED** (D-015) — purchased, now surplus |
| Status display | Small OLED for Brook Gen 5W | PURCHASED |
| Joystick | 8-way, Sanwa JLF or clone — stripped from existing cabinet | HAVE |
| Action buttons | 6 × 30 mm arcade pushbuttons — stripped from existing cabinet | HAVE |
| Wiring | Wire, crimps, quick-disconnect harness | HAVE |
| Battery connector | JST PH 2.0 mm pigtail (Brook battery input) | **NEEDED** |
| Charge port | Brook panel-mount board B-C16046: USB Type-B socket + 3.5 mm jack, 26.1 × 31 faceplate, 5-pin cable to the Brook (D-015 addendum) | HAVE (photographed 2026-09-13) — plus 2 × M3 × 8 screws and a USB-C-to-B charge cable |
| CC pull-ups | 2 × 56 kΩ resistors per pad | **NOT NEEDED** — the port is USB-B, no CC lines (2026-09-13) |
| Enclosure | 3D printed; Fusion CAD by Claude, owner reviews and prints (D-011). Five parts per pad: ring, sled, plate, TPU ring, TPU tyre (D-016) | **NEEDED** |
| Plate screws | 6 × M3 × 16 socket cap, into M3 heat-set inserts (6 × M3 × 4 mm, ⌀4 hole) in the plate | **NEEDED** (D-016) |
| Base bolts | 10 × M3 × 12 socket cap, from underneath through the TPU ring and sled: 6 at r 132.1 into the ring bosses, 4 at r 62 into sled bosses | **NEEDED** (D-016, D-017) |
| Port board screws | 2 × M3 × 8 into the rear boss pilots | **NEEDED** (stage I) |
| Zip ties | 2 × ≥200 mm, 4.8 wide, through the LiPo plinth tunnels | **NEEDED** (stage H) |
| Charger | TP4056 module with DW01 protection | **NOT NEEDED** (D-010) — purchased, now surplus |
| Boost converter | MT3608 3.7 V → 5 V | **NOT NEEDED** (D-002) |

## Charging station

| Role | Part | Status |
|---|---|---|
| ~~Qi transmitter pad~~ | ~~One per charging position~~ | **NOT NEEDED** (D-015) — purchased, now surplus |

## Pi console box

| Role | Part | Status |
|---|---|---|
| Console | Raspberry Pi 4 Model B | HAVE |
| System buttons | 6 arcade pushbuttons (P1–P4 Start, Select, Hotkey) | HAVE |
| Wiring | Wire, Dupont connectors | HAVE |
| Pull-down resistors | 10 kΩ | **NOT NEEDED** (D-005) — purchased, now surplus |
| USB-C panel mount | Power inlet on the drum's rear pads (D-021) | NEEDED |
| HDMI panel mount | micro-HDMI male to HDMI female extension, ≤ 30 cm (D-021) | NEEDED |
| USB-A ×2 panel mount | extension to the Pi's USB-A (D-021) | NEEDED |
| RJ45 panel mount | coupler extension to the Pi's ethernet (D-021) | NEEDED |
| Heatsink kit | Pi 4 set: SoC, RAM, USB controller (D-021) | NEEDED |
| M2.5 heat-set inserts + M2.5 × 6 | 4 + 4, Pi bosses (D-021) | NEEDED |
| M3 × 10 countersunk | 4, base to cup (D-021); M3 inserts from the pad stock | NEEDED |
| Filament | black PETG (base), black and red PLA (cup and inlays) | owner's stock |
| Enclosure | ⌀160 × 115 drum, Fusion CAD by Claude (D-011, D-021), owner reviews and prints | **NEEDED** |

## Notes

- The original project brief listed 18650 cells. That is superseded — the
  purchased battery is the 103395 pouch pack (D-001).
- The LiPo pack almost certainly ships with a plug that is *not* JST PH 2.0 mm.
  Buy pigtails; do not cut and twist.
- Nothing in this BOM covers a low-battery indicator beyond whatever the Brook's
  OLED reports. `[UNVERIFIED]` — confirm what the OLED actually displays.
- The 56 kΩ CC pull-ups are **not** the 10 kΩ pull-downs already purchased for
  the Pi console box, and they are not the 5.1 kΩ R_d a sink presents. Different
  value, different role. See `03-wiring-lap-pad.md`.
- Three modules are now surplus per pad: the MT3608 (D-002), the TP4056
  (D-010) and the Qi receiver (D-015), plus the Qi transmitter pads. Do not
  re-add any without reading the decision log.
- In the Pi console box the 10 kΩ pull-downs are surplus too (D-005): the
  buttons wire GPIO→GND and the overlay uses the SoC's internal pull-up.
