emp3thy/arcade-cabinet/docs/STEP_Reference_Files/All_Components_Assembly.step

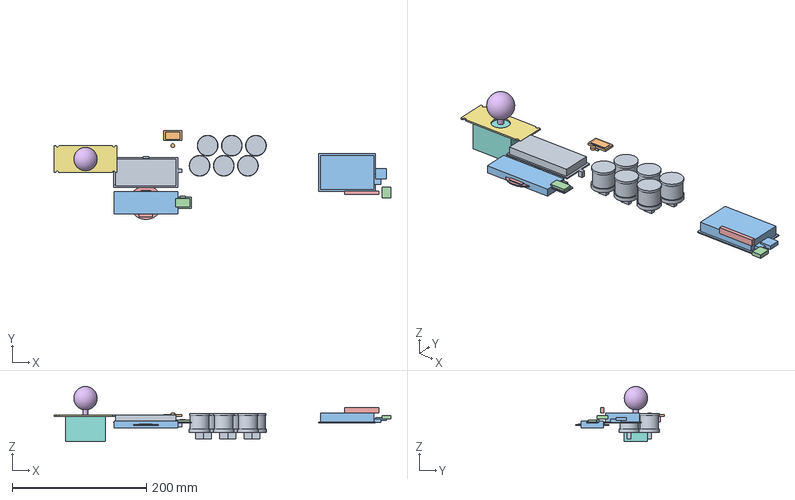
[picture p52: CAD file, 2026-09-13]
docs/STEP_Reference_Files/All_Components_Assembly.step
502.2 x 132.5 x 82.0 mm
Brook_Gen5W
LiPo_Battery
TP4056_Charger
Qi_Coil
Sanwa_JLF_Joystick
Button_P1
Button_P2
Button_P3
Button_P4
Button_P5
Button_P6
OLED_Display
RaspberryPi_4B
