emp3thy/arcade-cabinet/docs/STEP_Reference_Files/Lap_Pad_Assembly_Reference.step

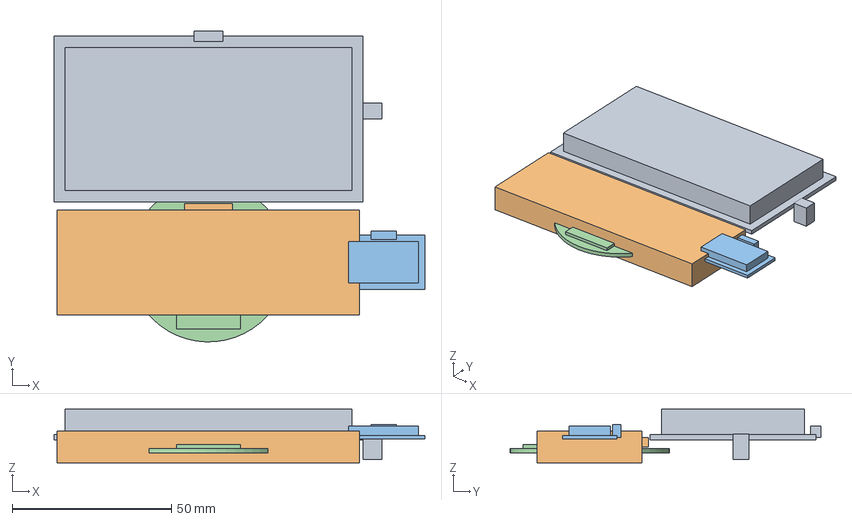
[picture p53: CAD file, 2026-09-13]
docs/STEP_Reference_Files/Lap_Pad_Assembly_Reference.step
116.5 x 97.6 x 16.8 mm
Brook_Gen5W
LiPo_Battery
TP4056
Qi_Coil
