emp3thy/arcade-cabinet/cad/art/drum/chunli_side.dxf

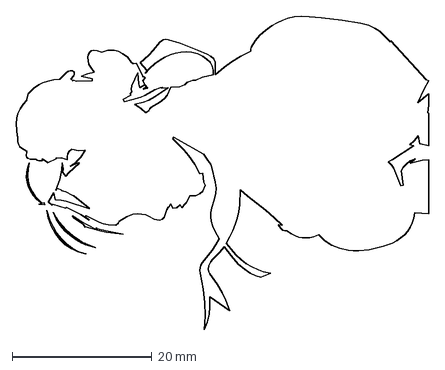
[picture p54: CAD file, 2026-10-25]
cad/art/drum/chunli_side.dxf
59.0 x 44.8 mm
