emp3thy/arcade-cabinet/cad/art/logo/sf2_deboss_solid.dxf

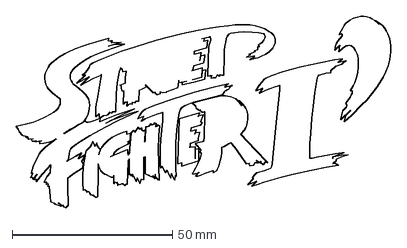
[picture p55: CAD file, 2026-09-13]
cad/art/logo/sf2_deboss_solid.dxf
117.0 x 59.8 mm
