emp3thy/arcade-cabinet/docs/STEP_Reference_Files/Brook_Gen5W_97x52.step

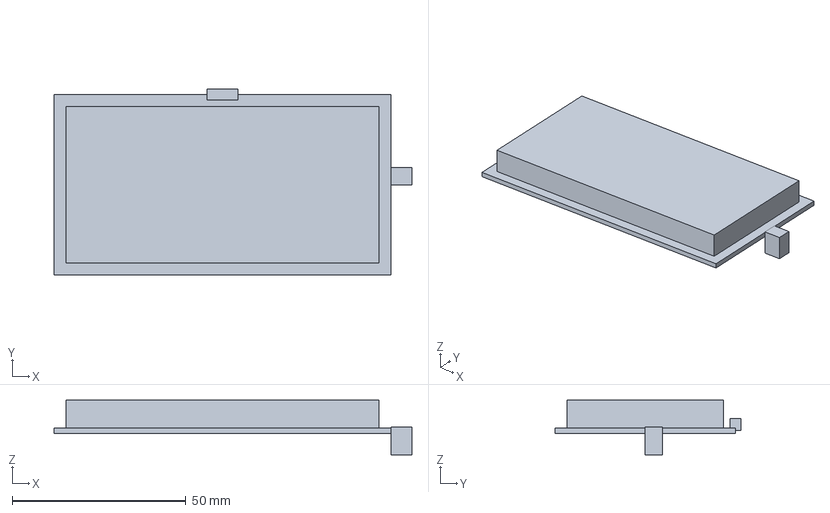
[picture p56: CAD file, 2026-09-13]
docs/STEP_Reference_Files/Brook_Gen5W_97x52.step
103.0 x 53.6 x 15.8 mm
