emp3thy/arcade-cabinet/cad/art/drum/sf2_solid_art.dxf

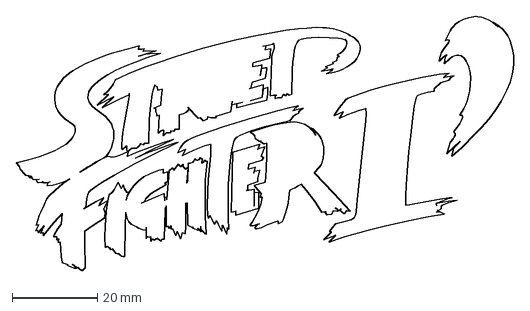
[picture p57: CAD file, 2026-10-25]
cad/art/drum/sf2_solid_art.dxf
117.0 x 59.8 mm
