emp3thy/arcade-cabinet/cad/art/drum/chunli_sil.dxf

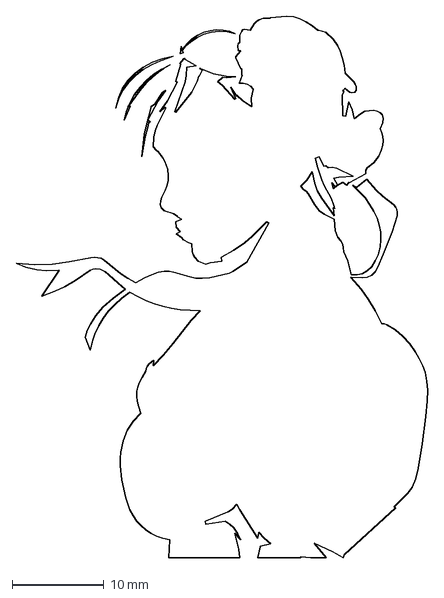
[picture p58: CAD file, 2026-10-25]
cad/art/drum/chunli_sil.dxf
44.8 x 59.0 mm
