emp3thy/arcade-cabinet/cad/art/logo/sf2_deboss_holes.dxf

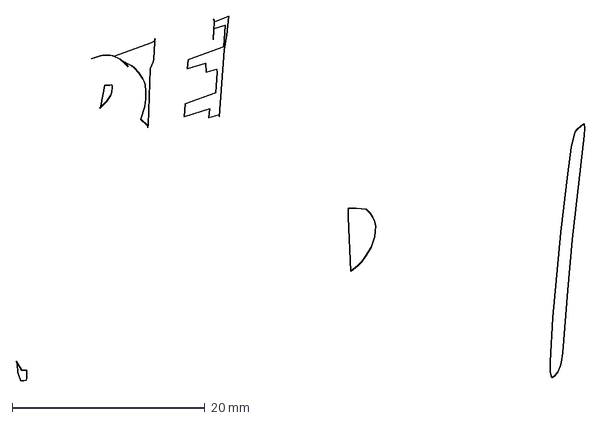
[picture p59: CAD file, 2026-09-13]
cad/art/logo/sf2_deboss_holes.dxf
58.9 x 37.8 mm
