emp3thy/arcade-cabinet/docs/STEP_Reference_Files/RaspberryPi_4B_85x56.step

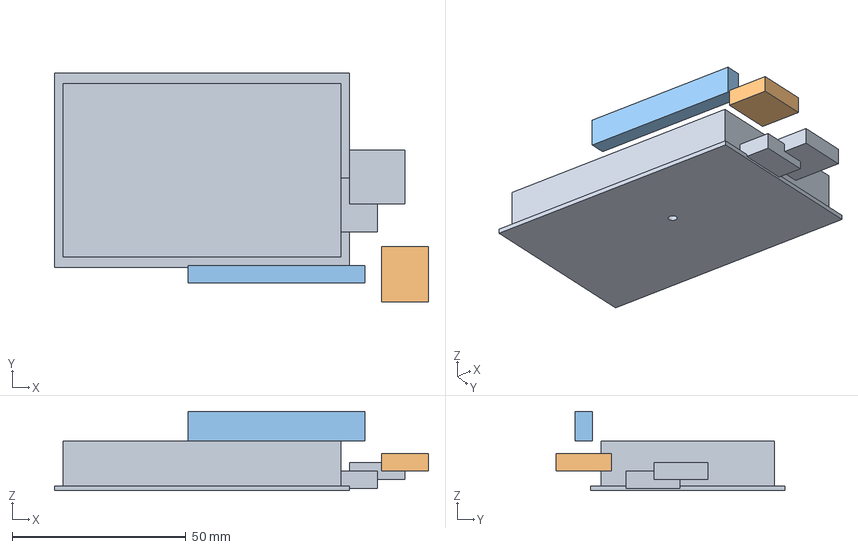
[picture p60: CAD file, 2026-09-13]
docs/STEP_Reference_Files/RaspberryPi_4B_85x56.step
107.8 x 66.0 x 22.9 mm
