emp3thy/arcade-cabinet/cad/art/logo/sf2_red.dxf

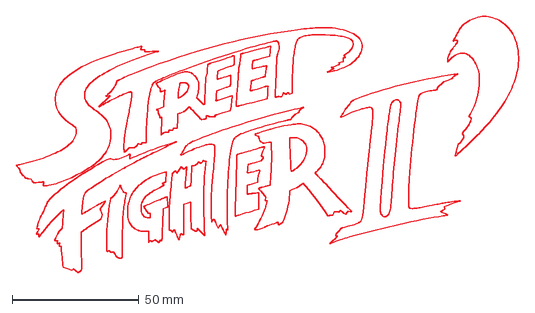
[picture p61: CAD file, 2026-09-13]
cad/art/logo/sf2_red.dxf
198.0 x 101.1 mm
