emp3thy/arcade-cabinet/docs/STEP_Reference_Files/Arcade_Button_30mm.step

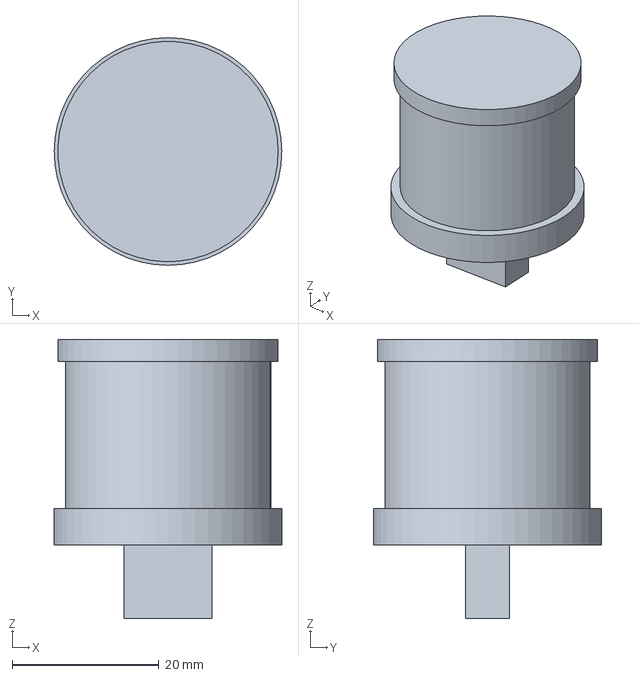
[picture p62: CAD file, 2026-09-13]
docs/STEP_Reference_Files/Arcade_Button_30mm.step
31.0 x 31.0 x 38.0 mm
