emp3thy/arcade-cabinet/cad/art/logo/sf2_combined.dxf

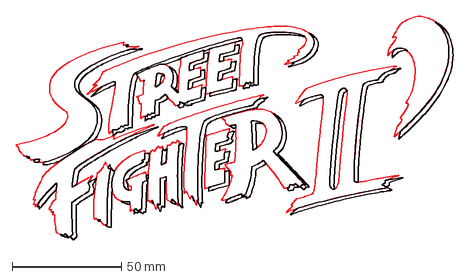
[picture p63: CAD file, 2026-09-13]
cad/art/logo/sf2_combined.dxf
199.8 x 102.1 mm
