emp3thy/arcade-cabinet/docs/STEP_Reference_Files/TP4056_26x17.step

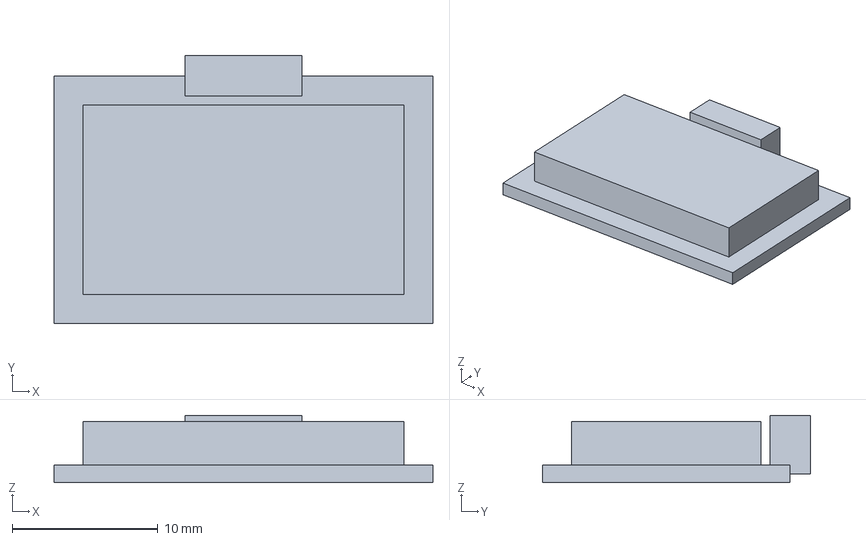
[picture p64: CAD file, 2026-09-13]
docs/STEP_Reference_Files/TP4056_26x17.step
26.0 x 18.4 x 4.60 mm
