emp3thy/arcade-cabinet/cad/art/logo/sf2_black.dxf

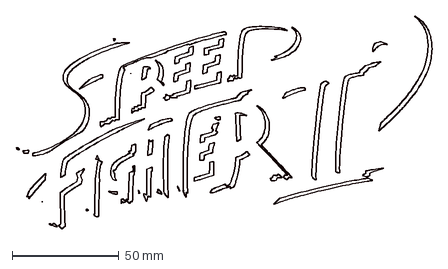
[picture p65: CAD file, 2026-09-13]
cad/art/logo/sf2_black.dxf
195.1 x 99.6 mm
