emp3thy/arcade-cabinet/docs/STEP_Reference_Files/Sanwa_JLF_Joystick.step

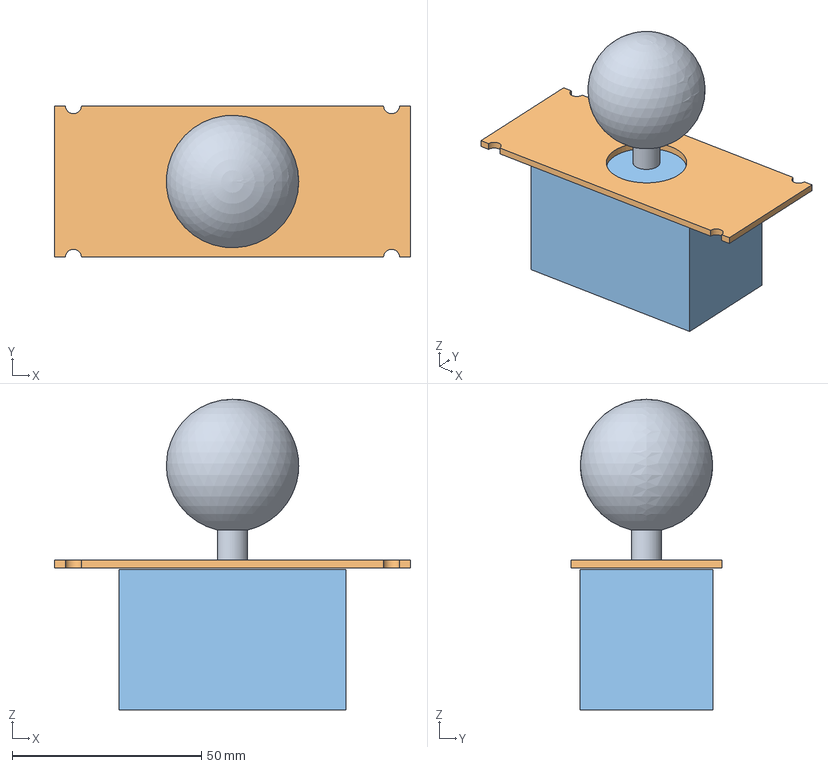
[picture p66: CAD file, 2026-09-13]
docs/STEP_Reference_Files/Sanwa_JLF_Joystick.step
94.0 x 40.0 x 82.0 mm
