emp3thy/arcade-cabinet/docs/STEP_Reference_Files/Brook_Gen5W_96x45_VERIFIED.step

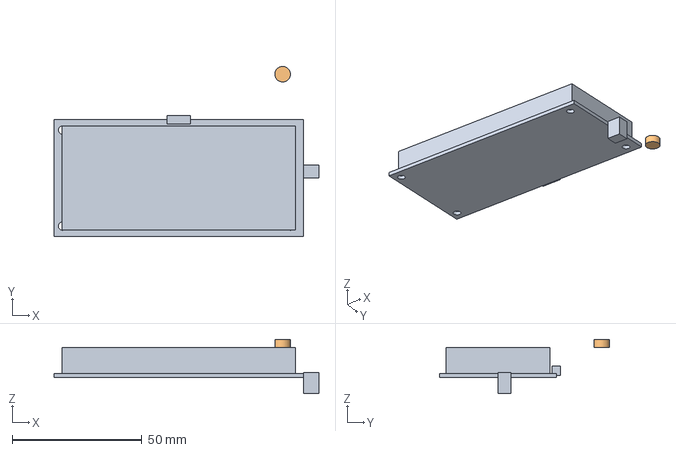
[picture p67: CAD file, 2026-09-13]
docs/STEP_Reference_Files/Brook_Gen5W_96x45_VERIFIED.step
102.0 x 65.5 x 20.8 mm
