emp3thy/arcade-cabinet/docs/STEP_Reference_Files/OLED_Display_27x15.step

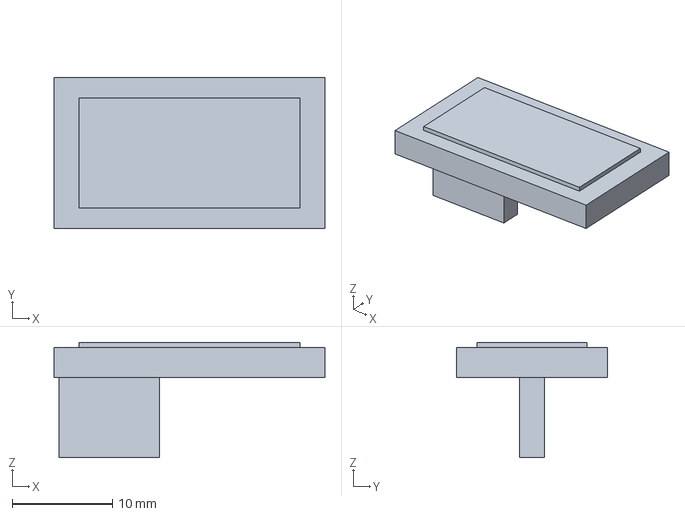
[picture p68: CAD file, 2026-09-13]
docs/STEP_Reference_Files/OLED_Display_27x15.step
27.0 x 15.0 x 11.5 mm
