emp3thy/arcade-cabinet/docs/STEP_Reference_Files/LiPo_3700mAh_103395_95x33x10.step

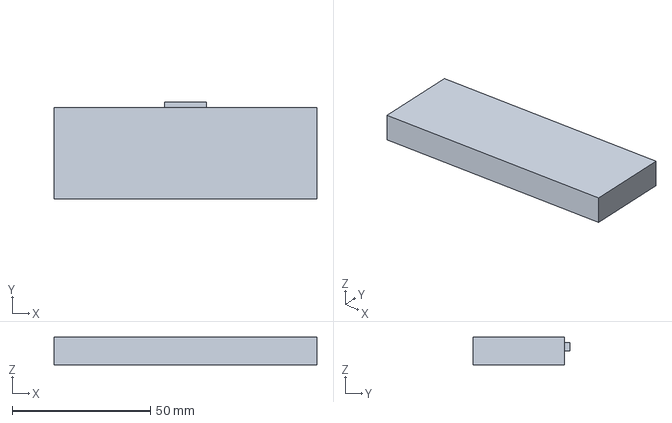
[picture p69: CAD file, 2026-09-13]
docs/STEP_Reference_Files/LiPo_3700mAh_103395_95x33x10.step
95.0 x 35.0 x 10.0 mm
