emp3thy/arcade-cabinet/docs/STEP_Reference_Files/Leg Foot diagonal.3mf

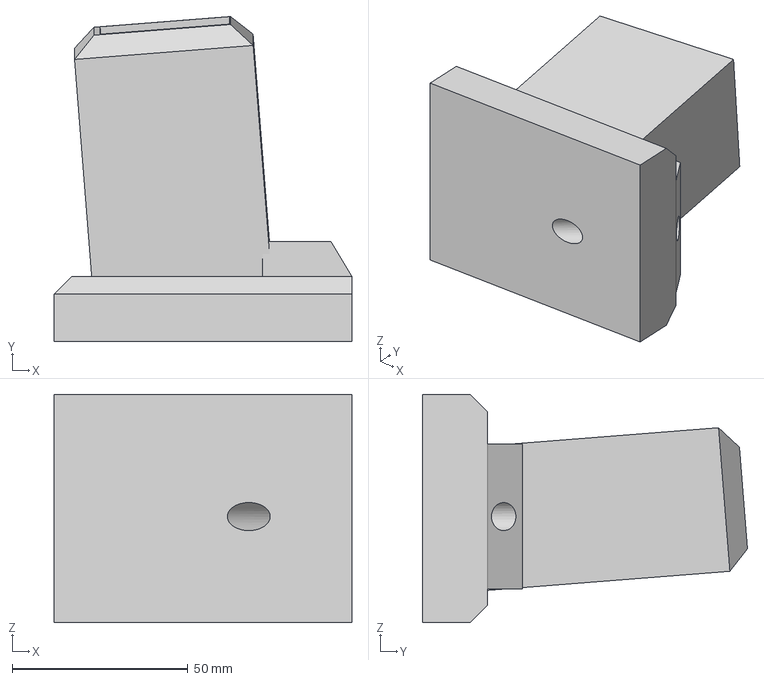
[picture p70: CAD file, 2026-09-13]
docs/STEP_Reference_Files/Leg Foot diagonal.3mf
84.8 x 92.5 x 65.0 mm
