emp3thy/arcade-cabinet/docs/STEP_Reference_Files/Qi_Receiver_Coil_50mm.step

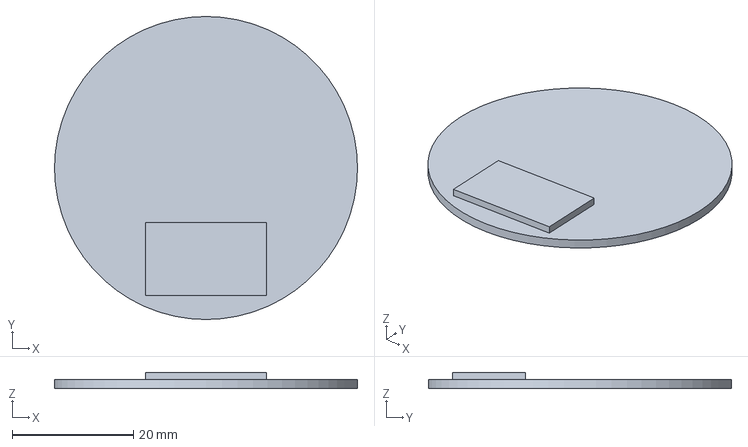
[picture p71: CAD file, 2026-09-13]
docs/STEP_Reference_Files/Qi_Receiver_Coil_50mm.step
50.0 x 50.0 x 2.70 mm
