emp3thy/arcade-cabinet/(list of files, cad)

Other CAD files:
cad/art/logo/sf2_deboss.dxf
