emp3thy/arcade-cabinet/cad/renders/lap_disc_stageL_assembly.png

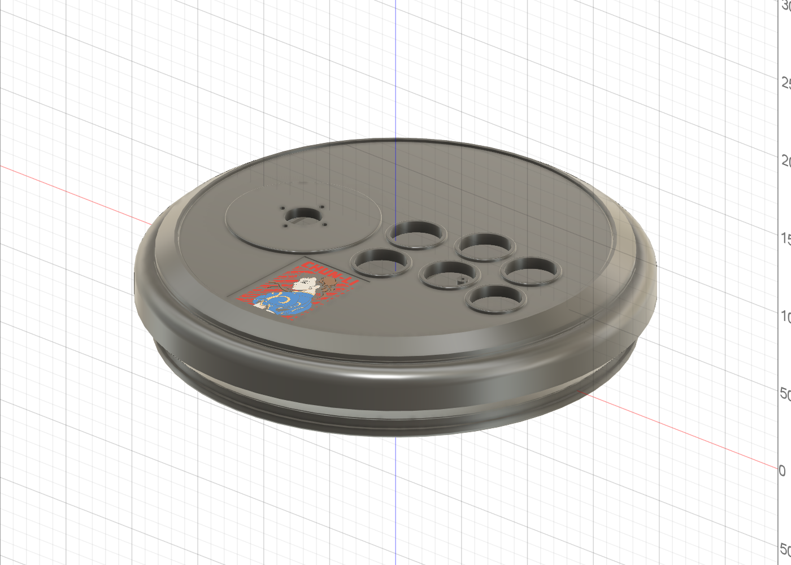
cad/renders/lap_disc_stageL_assembly.png
