emp3thy/arcade-cabinet/(commit log)

2026-09-13 Initial commit: lap pad disc CAD (stages A-D), enclosure docs, comfort study
    Fusion 360 build scripts for the D-014 nested-disc lap pad (cad/lap_disc*.py,
    bundled artifacts, renders), the numbered reference docs, the comfort study,
    STEP reference models and the vendored fusion-design skill.
    Claude-Session: https://claude.ai/code/session_01TLFAiZzNWnF4VMkfHBXUYP
    [All_Components_Assembly.step, Arcade_Button_30mm.step, Brook_Gen5W_96x45_VERIFIED.step, Brook_Gen5W_97x52.step, Lap_Pad_Assembly_Reference.step, Lap_Pad_Enclosure.scad, Leg Foot diagonal.3mf, LiPo_3700mAh_103395_95x33x10.step]
2026-09-13 Stage E: close the port-facet gap in the tyre, add a tyre window for the port
    The stage B facet left a 3.8 mm lens between the flat and the round tyre,
    open from above. Stage E joins that segment onto the TPU tyre and cuts a
    window through it in line with the port window; the port is the charging
    input and must stay reachable. Oracle corrected for the stage D fillets.
    Docs note the open conflict with D-010 (Qi-only charging).
    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
2026-09-13 D-015: lap pads charge through the rear USB-C port; Qi receiver dropped
    Owner's decision 2026-09-13: fewer components, simpler design. Decision log
    entry added; CLAUDE.md, architecture, BOM, lap pad wiring, testing, open
    issues and enclosure reference brought in line. Qi receiver, transmitter,
    coil boss and ring hole are out; CC pull-ups only if the port board lacks
    CC pass-through. Model cleanup (stage F) follows.
    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
2026-09-13 Stage F: remove the Qi coil boss and the ring's coil hole (D-015)
    Deletes the stage C coil boss (shell loses exactly the boss volume, underside
    back at z = 0), rebuilds the TPU ring from ring_od / ring_id alone and rounds
    it again with ring_r, then deletes the five coil parameters. The script
    activates the lap pad document by name first because two sessions share
    this Fusion instance. Green on first execute.
    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
2026-09-13 Chun-Li art placed on the plate as a Fusion decal
    cad/art/chunli.svg (owner's file) rasterised to chunli.png; decal on the
    plate top, 45.7 x 64 mm centred at (0, -84), the front band between the
    cluster and the rim. Visualisation only; printed form to be decided.
    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
2026-09-13 Art layers: identical 0.6 mm frame on every SVG so they import at one size and align
    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
2026-09-13 Stage G: 0.6 mm art pocket in the plate; decal moved onto its floor
    Pocket 50.1 x 68.4 mm (art + 2.2 mm a side) centred at (0, -85), exact
    volume oracle, all checks green. The owner's rolled-back Sketch27 / Scale1
    UI experiments are ignored by the health check. Lessons kept in the scripts:
    a raise inside an execute rolls the whole execute back; a cut floor can
    report a flipped surface normal; re-resolve faces after deleting a decal.
    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
2026-09-13 Stage H: stiffener pocket 53 x 95, LiPo plinth with zip-tie tunnels, antenna hoops
    Owner's fit-out requests 2026-09-13. Stiffener parameters swapped to match
    the docs (53 left-right, 95 front-to-back). 4 mm plinth under the cell with
    two 5 x 2 tie tunnels through plinth and tray walls. Five inverted-U cable
    hoops on the floor against the inner wall from the Brook round to the
    antenna bracket, each on a probed radial plane. All oracles exact; tie_dx
    proved live by read-back. Port board mount opened as OI-011: no board data.
    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
2026-09-13 Stage H renders: internals with plate and tyre hidden
    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
2026-09-13 Art layers rebuilt as non-overlapping vector cut-outs for Bambu
    cad/art/split_layers.py parses chunli.svg with true nonzero winding,
    subtracts every later-painted layer from each earlier one (zero pairwise
    overlap in every set) and gives each layer its own segments of a dashed
    frame so all files share one extent without stacking. Composite of the
    result matches the original raster to 0.2 %.
    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
2026-09-13 Art layers: white hair-bun layer, border replaced by alignment dots
    The bun covers are drawn in the mid-brown class but are white (owner);
    their ten shapes now form a white layer, so set4/set6 become set5/set7.
    The dashed border goes; each layer keeps four 0.6 mm dots, staggered so
    no two layers touch, which holds every file to the same extent.
    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
2026-09-13 Stage I: port board mount for Brook's USB-B panel board; docs corrected
    Owner's photos and measurements: Brook B-C16046, USB Type-B socket + 3.5 mm
    jack, faceplate 26.1 x 31, rear board 28.3 deep, diagonal M3 holes.
    Faceplate mounts against the inside of the rear boss with four 2.5 mm
    pilots; the boss window shrinks to a 22 x 16 plug tunnel (tyre window
    23 x 17). No CC lines on USB-B: pull-up question closed. OI-011 resolved,
    D-015 addendum, BOM, wiring and enclosure reference updated.
    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
2026-09-13 Port board pilots: hole centres 2 mm from the plate edges (owner)
    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
2026-09-13 Antenna hoops: 6 x 5 openings so the pigtail's connector passes
    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
2026-09-13 Stage J: bolted serviceable assembly (D-016)
    Shell split at the floor line into ring and sled; plate 5 mm with six M3
    inserts; six 45 deg screw gussets with spot faces (M3 x 16 from inside);
    continuous 45 deg wedge under the ledge so the ring prints open side up;
    six M3 x 12 base bolts through the TPU ring and sled into wall bosses;
    antenna bracket at 60 deg; tyre bottom edge chamfered for flat printing.
    Every feature volume-checked; bolt lines read back. Decision log D-016,
    enclosure reference and BOM updated.
    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
2026-09-13 Stages K and L: inner TPU bolts, ridge bevels, port board headroom (D-017)
    Stage K adds four M3 x 12 through the TPU ring's inner zone at r 62
    (15/195/255/315 deg) into 8 x 8 mm bosses on the sled floor, so the ring is
    clamped near its inner hole as well as at r 132.1, and bevels the undersides
    of both tyre locating ridges at 45 degrees so the ring prints open side up
    with no unsupported ledge.
    Stage L gives the port board its headroom back. The D-016 ledge wedge ran
    the whole way round, so over the port boss it refilled the two upper M3
    pilots and took the top 4.4 mm of the board's envelope. port_relief cuts a
    28 x 6 mm box out of the wedge from the boss face up to the ceiling,
    port_gable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
2026-09-13 Street Fighter II logo on the plate, above the buttons
    Owner supplied the logo as a two-layer DXF and SVG set in C:\dev\sf2_svg,
    one colour per layer: C00_ED1C24 red #ed1c24 (16 closed polylines) and
    C01_120203 near black #120203 (51), together 199.83 x 102.10 mm, aspect
    1.9569.
    Placement comes from a scan of the plate's free band above the buttons. The
    band is bounded below by the top button's raised disc at y 41 and above by
    the plate rim at r 124.65, so the logo sits 110 x 56.2 mm centred at
    (0, 71.6): 2.5 mm above the nearest button disc and 10.8 mm from the top
    corners to the rim. The theoretical maximum at a 6 mm rim margin is
    117.4 mm wide, so this leaves room to grow.
    cad/lap_disc_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
    [sf2_black.dxf, sf2_combined.dxf, sf2_red.dxf]
2026-09-13 Logo debossed into the plate; decal scripts kept as reference
    The Street Fighter II logo is now geometry, not a decal. The plate carries
    sf2_deboss, a 0.6 mm cut (parameter logo_deboss) from the sf2_solid sketch,
    with sf2_counters joining the enclosed islands of the letterforms back to
    flush so they read as raised counters inside the recess. Plate volume drops
    from 228.1 to 226.4 cm3.
    Size settled at the practical maximum: 117.0 x 59.8 mm centred at (0, 72.9),
    bottom edge at y 43.0, which leaves 2 mm to the top button's raised disc and
    6.4 mm from the top corners to the plate rim. Going wider buys nothing -- the
    round plate cuts the corners away faster than the extra width helps, so even
    at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
    [sf2_deboss.dxf, sf2_deboss_holes.dxf, sf2_deboss_solid.dxf]
2026-09-13 Stage M: the logo deboss as a script
    The deboss was modelled by hand, so the repo could not rebuild it -- every
    other stage A to L is a script. cad/lap_disc_m.py closes that gap.
    It imports cad/art/logo/sf2_deboss_solid.dxf onto plate_top_plane, cuts
    logo_deboss (0.6 mm) through all eight profiles, then imports
    sf2_deboss_holes.dxf and joins the same depth back under the six counters so
    they stand flush in the recess. The join reuses the direction the cut
    resolved: volume alone cannot tell a join that fills the recess from one that
    stands proud of the plate, since both add the same 0.0436 cm3.
    Placement is baked into the DXFs -- both are written in millimetres in model
    coordinates -- so th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
2026-09-13 Stage M validated by a full rebuild; face sweep no longer tests normal sign
    The hand-built deboss was deleted from the document -- sf2_counters,
    sf2_holes, sf2_deboss, sf2_solid, and the stray Sketch27 and Scale1 left by
    the manual import -- taking the plate back to 228.1113 cm3, and
    cad/lap_disc_m.py then rebuilt it from the DXFs. Every oracle matched the
    hand-built model exactly: the cut removed 1.7449 cm3 over 29.0823 cm2, the
    join returned 0.0435 cm3 over 0.7258 cm2, the recess floor read back as
    28.3566 cm2 at z 51.40 over seven faces, six counters sat flush at z 52.00
    totalling 0.7258 cm2, and the plate came back to 226.4099 cm3. The deletes
    were quick, not the pathological case the ha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
2026-09-13 Docs: D-018, the logo deboss
    09-decision-log.md gains D-018: the Street Fighter II logo is geometry, not a
    decal. It records the 0.6 mm recess and the counters joined back flush, the
    size and placement with the clearances that fix them, which DXFs the art comes
    from, the deletion of both decals with the placement scripts kept as reference,
    and the print consequence (nothing unsupported -- the floor faces up and the
    counters stand on it). Plate 228.1 -> 226.4 cm3; mass estimate unchanged.
    06-enclosure-reference.md gains the stage M entry above stage L, and the livery
    row is corrected: it still described the Chun-Li decal as present and did not
    mention the logo at all.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
2026-09-13 Stage N: anti-slide grooves in the TPU ring (D-019)
    The underside was one flat 486.2 cm2 face. A 2.2 kg pad over that area
    presses at about 0.44 kPa, which is too little to push 85A TPU into a denim
    weave or a beanbag's pile, so the pad gripped by adhesion alone.
    Eight concentric grooves are cut into it: groove_w 4 mm wide, groove_d 1 mm
    deep, groove_pitch 8 mm apart, centres r 69 to 125. Contact falls to
    291.2 cm2, so pressure on the lands rises about 1.67x; the TPU ring goes
    309.2 -> 289.7 cm3 and its z envelope is unchanged at -6..0.
    Cut rather than stood proud so the envelope and the ten bolt clamp faces stay
    as D-016 left them. Concentric rather than crosshatched: rings resist the
    for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
2026-09-25 Vendor print-in-place-design skill; record fusionhelper install
    Copy the print-in-place-design skill from FusionHelper alongside
    fusion-design (hazards.md refers to it). Update VENDORED.md with the
    correct source path (sources\, not source\), both skills' copy dates,
    and where the fusionhelper package now lives on this machine.
2026-10-18 Stage O: fixes from the first test print (D-020)
    The first print showed four problems; this stage fixes all of them in the
    ring, sled and tyre.
    USB port: the board is 31 x 26.1 with Ø3.2 holes 2.1 mm in from the edges,
    so the hole centres are 3.7 mm in (port_hole_inset = port_hole_gap +
    port_hole_d / 2) and the pilots move to (±9.35, ±11.8). The opening grows
    equally about its centre to 21.1 mm high (port_open_h), width unchanged at
    22. To keep 1 mm of wall around each M3 thread it is built as two cuts:
    the full-width window at 18.6 mm plus a 13.7 mm wide slot to 21.1, which
    leaves a notch at each corner. check_port_layout asserts both clearances
    before cutting. The tyre window follows,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
2026-10-22 D-021: the Pi console is a drum in SF2 livery; spec approved
    Design spec for the console unit, approved by the owner 2026-10-22:
    a 160 x 115 mm drum in two bolted parts (PETG base with the Pi and four
    panel-mount socket pads, PLA cup with six buttons, the Chun-Li art pocket
    and red inlay livery). Decision log D-021, enclosure reference Pi section
    replaced, BOM additions, thermal and fit checks in testing, OI-012 (Ryu
    art) and OI-013 (socket dimensions) opened, CLAUDE.md updated.
2026-10-22 Plan for the console drum; spec amended for a flat, channelled floor
    Implementation plan in seven tasks: launcher through FusionHelper's MCP
    client, the art script, stages A to E, owner actions. Two spikes run
    today in a scratch Fusion document proved the wrapped emboss, the counter
    fill-back and the inlay-by-subtraction, so A5 and A6 are verified.
    Spec amendment found in planning: rim notches cannot admit air to a
    floor that stands flat, and feet would make the floor an unsupported
    bridge on a face-up print. The base now has eight 12 x 2 channels in
    its underside with two intake holes each. Enclosure reference updated.
2026-10-22 Launcher: pass_partial with no failed check is green
    A one-body stage skips interference and clearance, so the verify block
    reports pass_partial; the launcher now exits 0 when nothing that ran
    failed and names any failed check.
2026-10-22 Stage A: the drum base (D-021)
    Floor, wall, eight underside channels, sixteen intake holes, four Pi
    bosses with insert bores, four countersunk screw holes. Every feature
    matched its analytic volume to four decimals; verdict pass_partial
    (interference and clearance skipped on one body), liveness pass with the
    four symmetric parameters proven live in-script.
2026-10-22 Drum art: silhouette union and DXF placement script, art-space files
    silhouette unions the figure's classes of cad/art/chunli.svg (the poster's
    red title, stripes and lettering excluded), closes 0.4 mm hairlines and
    drops specks under 1 mm2: five pieces, 467 vertices, 44.8 x 59. The two
    logo DXFs are re-centred into art space. Spec sil_w amended to 44.8.
2026-10-22 Stage B: socket pads with placeholder cutouts (OI-013)
    Four flats, blocks, cutouts and pilot pairs on radial planes with
    symmetric extrudes, every sketch asserted in model space before its
    extrude. Pilots 4 mm blind (6 broke through the 5 mm block). Verdict
    pass_partial on the sixth execute, liveness pass with the four screw
    pitches proven live in-script.
2026-10-22 Stage C: the cup, buttons, art pocket, columns and vents (D-021)
    Wall and lid, six button holes read back at their signed centres, the
    art pocket with a single planar floor, four webs then four columns with
    insert bores, exhaust groove and sixteen slots, joint chamfers as revolved
    cuts. First execute: verdict pass_partial with interference and liveness
    passing; cup 195.73 cm3, base 100.62 cm3 after its chamfer.
2026-10-22 Stage D: wrapped SF2 logo and silhouettes with inlay bodies (D-021)
    Three debosses 1.2 deep wrapped onto the cup from placement-baked DXFs
    (mapping probe kept as pi_drum_d_probe.py), one emboss per profile with
    islands first and a zero-area regioning sliver skipped. Inlays are the
    pre-deboss copy minus the cup; the logo's six counters are cut from their
    letters and joined back into the cup. Every volume identity exact. Fusion
    returns disconnected booleans as separate bodies and declined to merge
    them, so the inlays are 7 + 5 + 5 pieces. Seventh execute: timeline,
    interference and liveness pass; constraints fail only on the imported
    art sketches, the documented exception. drum_art gains union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
2026-10-22 Stage E: print fixes, overhang audit, exports, renders; D-021 addendum
    Webs rise to z 46 with a 45 deg roof cut over each web and column, a foot
    under each socket pad block, the silhouette specks joined back into the
    cup. The face-normal audit in print orientation classifies every
    down-facing face on all eleven bodies with none unclassified. STEP and
    3MF exported. Spec, enclosure reference, CLAUDE.md and the decision log
    record the amendments.
2026-10-22 Stage F: Pi re-seated and column feet lowered (review fixes); launcher --allow
    A Pi 4B's holes are 3.5 and 61.5 from the SD edge, so the centred hole
    pattern had put the USB edge against the back columns. The board now lies
    lengthways, USB edge to the front, HDMI edge to the left, centre 10 mm
    back: 44.5 mm of plug room in front, 49 on the left, asserted in-script.
    Column feet drop to 0.3 mm above the floor. Every oracle exact; verdict
    green with the imported-art constraints exception declared through the
    launcher's new --allow flag (tests 10/10). Spec, reference and D-021
    addendum amended.
